cbake6807/PICO-SIGGEN-v1/GatedPulsePico/GatedPulsePico.ino

// GatedPulsePico — networked gated pulse-train generator, Raspberry Pi Pico 2 W
//
// Port of ../GatedPulse (Arduino Nano). Same knob/serial UX, but the RP2350
// changes the design: PIO does the gating in hardware, so the AVR's
// software-AND compromise is gone and no 74HC08 is needed.
//
//   ext sig gen ──► GP3 ─┐
//                        ├─► PIO gating SM ──► GP5   gated pulse train
//   int carrier ──► GP2 ─┘        ▲            GP4   gate / burst marker
//   (PIO gate_gen)                │
//                                 └─ COUNT: SM counts input pulses
//                                    TIME : second gate_gen SM drives GP4
//
// Edge fidelity, measured in clocks rather than guessed:
//   Nano software AND     562 ns worst-case error, 1.7 % blind time
//   Nano + 74HC08         ~10 ns, extra chip
//   Pico 2 W PIO          ~20 ns constant delay, +/-6.7 ns jitter, no extra parts
//
// PIO runs independently of the CPU, so WiFi, HTTP, USB and the encoder cannot
// perturb the output. On the Nano every one of those punched holes in it.
//
// Three ways to drive it, all sharing one command interpreter:
//   - rotary encoder + buttons
//   - USB serial (type ? for help)
//   - HTTP on the LAN:  GET /state          -> JSON
//                       GET /cmd?c=<command> -> runs any command, returns text
//                       GET /                -> small web UI
// tools/gatedpulse.py and tools/mcp_server.py on the host wrap the HTTP API.
//
// !! 3.3 V ONLY !! RP2350 GPIO is NOT 5 V tolerant, unlike the Nano this
// replaces. A 5 V sig-gen output WILL damage GP3. Use a divider (10k series +
// 20k to ground) or a 74LVC1G17 buffer on 3V3. See README.

#include <Arduino.h>
#include <stdio.h>            // sscanf, for parsing RAMP1/RAMP2's multi-value argument
#include <hardware/pio.h>
#include <hardware/pwm.h>
#include <hardware/clocks.h>
#include <hardware/gpio.h>
#include <hardware/dma.h>
#include <hardware/irq.h>
#include <string.h>           // memcpy/memset, for the settings blob
#include <EEPROM.h>           // emulated in one flash sector -- see cfgWrite()

// Forward-declared for arduino-cli's auto-generated prototypes. It inserts the
// whole block immediately above the file's FIRST function definition, so any
// struct a function signature mentions has to be declared above that point --
// and where that point lands moves whenever a helper is added near the top.
// Declaring every struct that appears in a signature here makes the build
// independent of that, rather than quietly breaking on the next edit. A
// reference to an incomplete type is perfectly legal in a declaration.
struct Settings;
struct RampCfg;
struct ElongCfg;
struct SeqStep;
#include <WiFi.h>
#include <WebServer.h>
#include <HTTPUpdateServer.h>
#include <LittleFS.h>
#include <LEAmDNS.h>

// WiFi credentials live in secrets.h, which is gitignored. Without it the
// firmware still builds and runs — it just stays offline.
#if __has_include("secrets.h")
  #include "secrets.h"
#endif
#ifndef WIFI_SSID
  #define WIFI_SSID ""
  #define WIFI_PASS ""
#endif
#ifndef MDNS_NAME
  #define MDNS_NAME "gatedpulse"
#endif

// Which firmware is this? Reported in /state, P and the boot banner, so "is
// the board running the new page or the old one" is answered by the board
// rather than guessed from what the UI looks like. FW_BUILD comes from
// build_info.h, which `make pico` writes from git; a bare arduino-cli build
// falls back to the compile time.
#define FW_VERSION "2.0.0"
#if __has_include("build_info.h")
  #include "build_info.h"
#endif
#ifndef FW_BUILD
  #define FW_BUILD __DATE__ " " __TIME__
#endif

// Firmware update over WiFi (POST /update), the way to reflash a board that
// is wired into a bench rig instead of sitting on the desk by a USB port.
// Off unless secrets.h sets OTA_PASS -- an unauthenticated flash endpoint on
// a box that drives high-voltage hardware is not a default worth shipping.
#ifndef OTA_USER
  #define OTA_USER "gatedpulse"
#endif
#ifndef OTA_PASS
  #define OTA_PASS ""
#endif

// ---------- Pins ----------
// GP3 is odd on purpose: PWM channel B is the one with an edge-count input
// mode, and channel B lives on odd GPIOs. GP4/GP5 are adjacent on purpose so
// one SET pin group can drive both in COUNT mode.
static const uint PIN_CARRIER    = 2;   // internally generated carrier (SRC INT)
static const uint PIN_SIG_IN     = 3;   // external sig-gen square wave (3.3 V!)
static const uint PIN_GATE_OUT   = 4;   // gate / burst marker — scope trigger
static const uint PIN_GATED_OUT  = 5;   // the gated pulse train
static const uint PIN_ENC_A      = 6;
static const uint PIN_ENC_B      = 7;
static const uint PIN_ENC_SW     = 8;   // press: select which param the knob edits
static const uint PIN_DISABLE    = 9;   // press: output on/off
static const uint PIN_MODE_SW    = 10;  // toggle: LOW = TIME, HIGH = COUNT
static const uint PIN_STATUS_LED = 15;  // external LED + resistor

// HV enclosure interlock. Board pin 31, with AGND right beside it at pin 33,
// so the whole connection is a two-pin header.
//
// Polarity is chosen so every way this can break lands on "unsafe":
//   closed (safe)  = pin pulled to GND by the sensor or switch
//   open           = pin floats to the internal pull-up
// A cut wire, an unpowered sensor, or nothing plugged in at all reads HIGH,
// which is the open case. The alternative polarity would report "lid closed"
// for a disconnected cable, which is exactly the failure a safety input exists
// to catch. Same pull-up-and-switch-to-ground convention as every other input
// here (RP2350 erratum E9 rules out the pull-downs).
static const uint PIN_INTERLOCK  = 26;  // board pin 31, GND at pin 33

// Second and third encoders: independent carrier controls. GP15 is skipped
// (status LED) and GP23/24/25/29 are avoided even though this board doesn't
// break them out at all -- on the plain Pico W they are wired straight to the
// CYW43 radio, so staying off that range is a cheap habit to keep.
static const uint PIN_ENC2_A     = 11;  // carrier frequency, or T1 width in T12 mode
static const uint PIN_ENC2_B     = 12;
static const uint PIN_ENC2_SW    = 13;  // press: toggle freq+duty vs T1/T2-independent editing
static const uint PIN_ENC3_A     = 14;  // carrier duty, or T2 space in T12 mode
static const uint PIN_ENC3_B     = 16;
static const uint PIN_ENC3_SW    = 17;  // press: toggle T1/T2 elongation ramp on/off

// Amplitude / tap select: 3 consecutive pins driven by the elongation SM's OUT
// group, intended for a 74HC138-style one-hot decoder feeding one opto +
// high-side leg per level. A decoder rather than three independent enables on
// purpose: two taps of one winding conducting at once shorts the turns between
// them, and one-hot in hardware makes that combination unreachable no matter
// what the firmware asks for. Harmless when nothing is wired -- the pins just
// toggle into open air.
// Dedicated panel button for the output mode (single / offset / sync). It gets
// its own pin because the modes are INDEPENDENT axes -- you may well want
// elongation with offset, or sweep with sync -- and folding them into one
// cycling control made combinations unreachable.
static const uint     PIN_PHASE_SW = 21;   // board pin 27, GND at pin 28

// ---- front-panel input map + event log ------------------------------------
// Wiring an encoder panel is the one job where "it does nothing" has half a
// dozen indistinguishable causes: A and B swapped, the common not grounded, a
// joint that never took, the wrong board pin counted from the wrong end. The
// raw edge log separates them in seconds -- if a pin never toggles it is the
// wiring, and if it toggles but no step is ever decoded it is the pairing.
//
// Board pin numbers live here too, because that is the number you count on the
// header while probing, and having to cross-reference GP-to-board in the
// middle of debugging is how the wrong pin gets blamed.
struct InputPin { uint gp; uint8_t board; const char *name; };
static const InputPin INPUTS[] = {
  { PIN_ENC_A,     9, "enc1 A"  }, { PIN_ENC_B,   10, "enc1 B"  },
  { PIN_ENC_SW,   11, "enc1 sw" }, { PIN_DISABLE, 12, "out en"  },
  { PIN_MODE_SW,  14, "T/C sw"  }, { PIN_ENC2_A,  15, "enc2 A"  },
  { PIN_ENC2_B,   16, "enc2 B"  }, { PIN_ENC2_SW, 17, "enc2 sw" },
  { PIN_ENC3_A,   19, "enc3 A"  }, { PIN_ENC3_B,  21, "enc3 B"  },
  { PIN_ENC3_SW,  22, "enc3 sw" }, { PIN_PHASE_SW, 27, "mode sw" },
};

// Kinds: 0 = raw pin edge, 1 = decoded detent step.
// kind 2 carries `msg` -- what the firmware DECIDED the input meant. Raw
// edges tell you the wiring is sound; this tells you the knob you turned moved
// the parameter you expected, which is a different failure and a commoner one.
struct InEvent { uint32_t ms; uint8_t gp; uint8_t level; uint8_t kind;
                 int8_t step; char msg[28]; };
static const uint16_t INLOG_MAX = 128;
static InEvent  inLog[INLOG_MAX];
static uint32_t inLogSeq = 0;          // total ever logged; the UI polls "since"

static void inLogPush(uint8_t gp, uint8_t level, uint8_t kind, int8_t step) {
  InEvent &e = inLog[inLogSeq % INLOG_MAX];
  e.ms = millis(); e.gp = gp; e.level = level; e.kind = kind; e.step = step;
  e.msg[0] = 0;
  inLogSeq++;
}

// What the panel just did, in words. Called from the apply/toggle paths where
// the firmware already knows the outcome, so the log cannot drift from what
// actually happened.
static void inLogAction(const char *fmt, ...) {
  InEvent &e = inLog[inLogSeq % INLOG_MAX];
  e.ms = millis(); e.gp = 0; e.level = 0; e.kind = 2; e.step = 0;
  va_list ap; va_start(ap, fmt);
  vsnprintf(e.msg, sizeof(e.msg), fmt, ap);
  va_end(ap);
  inLogSeq++;
}

// Every input, every loop. Deliberately NOT debounced and NOT filtered: bounce
// is one of the things you are looking for, and a "clean" log would hide the
// noisy contact that is actually causing the miscounts.
static void pollInputWatch() {
  static uint32_t last = 0;
  static bool     primed = false;
  uint32_t m = 0;
  for (uint i = 0; i < count_of(INPUTS); i++)
    if (gpio_get(INPUTS[i].gp)) m |= (1u << i);
  if (!primed) { last = m; primed = true; return; }
  uint32_t diff = m ^ last;
  if (!diff) return;
  for (uint i = 0; i < count_of(INPUTS); i++)
    if (diff & (1u << i)) inLogPush((uint8_t)INPUTS[i].gp, (m >> i) & 1u, 0, 0);
  last = m;
}

// Runtime-settable (PHASEPIN), not a constant: every panel is wired
// differently, and the base only has to satisfy "three consecutive free GPIOs".
// Baking it in meant anyone whose encoders landed here had to edit and rebuild.
static uint           ampBase    = 18;  // default GP18/19/20 = A0/A1/A2
static const uint     AMP_BITS   = 3;
static const uint32_t AMP_MASK   = (1u << AMP_BITS) - 1;   // codes 0..7

// Cycle marker: high for the whole of burst 1 of the repeating pattern, low for
// every other burst. It exists because GP4 pulses on EVERY burst, so in offset
// mode a scope has no way to tell burst 1 from burst 3 and the trace walks --
// the workaround was triggering off one channel with holdoff, which is fragile
// and drifts the moment the ring length changes.
//
// It rides the same OUT group as the channel bits rather than a second state
// machine, so it is generated from the same DMA word that picks the channel and
// cannot drift from it by even a clock. PIO pin groups are consecutive, so
// reaching GP22 from base GP18 means a 5-wide group, and bit 3 lands on GP21 --
// the mode button. That bit is simply never driven: GP21's function stays SIO,
// so the PIO block is not connected to that pad and its writes there go
// nowhere. Costs one wasted bit in the pushed word and nothing at runtime.
static const uint     CYCLE_BIT  = 4;                       // bit 3 = GP21 hole
static const uint     OUT_BITS   = CYCLE_BIT + 1;           // GP18..GP22
static const uint32_t CYCLE_MASK = 1u << CYCLE_BIT;
static inline uint    cyclePin()  { return ampBase + CYCLE_BIT; }   // GP22

// Named PIN_STATUS_LED, not PIN_LED: the rpipico2w variant already defines
// PIN_LED as 64, because the onboard LED hangs off the CYW43 WiFi chip rather
// than a GPIO. That one is used for link status once WiFi is up.

// ============================================================================
// PIO programs
// ============================================================================
//
// Hand-maintained encodings — arduino-cli does not run pioasm during a sketch
// build. The .pio sources next to this file are the readable original, and
// `make pioverify` re-assembles them and diffs against these arrays, so the
// two cannot silently drift.

// ---- Combined gating program (gating.pio) --------------------------------
//
// Both engines live in ONE program so dynamic PIO claiming can never split
// them across blocks. COUNT entry = offset+0, TIME entry = offset+17.
//
// The SET pin group differs per mode and is configured on the state machine:
//   COUNT: base GP4, count 2  -> bit0 = burst marker, bit1 = gated output
//   TIME : base GP5, count 1  -> bit0 = gated output
//
// COUNT half: passes ON input pulses then mutes OFF input pulses, forever, with
// no CPU involvement. It only ever raises the output after a rising edge and
// lowers it after the matching falling edge, so every burst is exactly ON
// *whole* pulses — no runts, at any input frequency.
//
// TIME half: ANDs the input with a gate level read through JMP_PIN. The `wait 0`
// before each pulse is what keeps it runt-free — a gate opening mid-pulse skips
// the remainder and starts clean on the next rising edge. Gate closure is
// likewise deferred to the end of the pulse in flight, at most one input period.
static const uint16_t gating_insns[] = {
  0x2020,  //  0: wait 0 pin 0        sync: begin from a low input  <-- COUNT entry
  0x8080,  //  1: pull noblock      burst: OSR = new word, or X (current)
  0xa027,  //  2: mov  x, osr       got:   keep it for the next burst
  0x6050,  //  3: out  y, 16          Y = ON-1
  0xe001,  //  4: set  pins, 1        marker high, output low
  0x20a0,  //  5: wait 1 pin 0      pass:
  0xe003,  //  6: set  pins, 3        output follows input
  0x2020,  //  7: wait 0 pin 0
  0xe001,  //  8: set  pins, 1
  0x0085,  //  9: jmp  y--, 5
  0xe000,  // 10: set  pins, 0        burst over, marker low
  0x6050,  // 11: out  y, 16          Y = OFF
  0x0072,  // 12: jmp  !y, 18         0 = one-shot -> park
  0x008e,  // 13: jmp  y--, 14        pre-decrement: mute counts OFF pulses
  0x20a0,  // 14: wait 1 pin 0      mute:
  0x2020,  // 15: wait 0 pin 0
  0x008e,  // 16: jmp  y--, 14
  0x0001,  // 17: jmp  1
  0x80a0,  // 18: pull block        park: one-shot done, wait for a word
  0x0002,  // 19: jmp  2
  0x00d7,  // 20: jmp  pin, 23     tloop:   <-- TIME entry
  0xe000,  // 21: set  pins, 0        gate shut, hold low
  0x0014,  // 22: jmp  20
  0x2020,  // 23: wait 0 pin 0     topen:
  0x20a0,  // 24: wait 1 pin 0
  0xe001,  // 25: set  pins, 1
  0x2020,  // 26: wait 0 pin 0
  0xe000,  // 27: set  pins, 0
  0x0014,  // 28: jmp  20
};
static const pio_program_t gating_program = {
  .instructions = gating_insns,
  .length       = count_of(gating_insns),
  .origin       = -1,
};
static const uint GATING_ENTRY_COUNT = 0;
static const uint GATING_ENTRY_TIME  = 20;

// ---- Square-wave generator (gate_gen.pio) --------------------------------
//
// Independent 32-bit high and low counts. Replaces the AVR's Timer1: that
// topped out at a 4.19 s period, this reaches hours while still resolving
// 6.67 ns at clkdiv 1. Two instances run: the TIME-mode gate, and the internal
// carrier. Fixed loop overhead is compensated on the CPU side —
// high = N + 3 cycles, low = M + 4 cycles (see genCycles()).
static const uint16_t gate_gen_insns[] = {
  0x80a0,  //  0: pull block          OSR = low-1
  0xa0c7,  //  1: mov  isr, osr
  0x80a0,  //  2: pull block          OSR = high-1
  0xa027,  //  3: mov  x, osr       cycle:
  0xe01f,  //  4: set  pins, 31     all bits of the SET group -- see the .pio
  0x0045,  //  5: jmp  x--, 5      hi:
  0xa046,  //  6: mov  y, isr
  0xe000,  //  7: set  pins, 0
  0x0088,  //  8: jmp  y--, 8      lo:
  0x0003,  //  9: jmp  3
};
static const pio_program_t gate_gen_program = {
  .instructions = gate_gen_insns,
  .length       = count_of(gate_gen_insns),
  .origin       = -1,
};

// ---- Retunable square wave (carrier_live.pio) -----------------------------
//
// gate_gen loads its two counts once, so retuning it meant stopping it and
// starting a new one: the current pulse was cut short and the burst count
// downstream restarted. Every edit -- every detent of a drag -- was a glitch.
//
// This one re-reads ONE packed word (low half hi-3, high half lo-5) at the top
// of every period with a nonblocking pull. An empty FIFO makes that pull act
// as `mov osr, x`, and X holds the current word, so the wave repeats until the
// CPU posts a new one; then T1 and T2 change together at a period boundary.
// Used for the internal carrier and for the TIME-mode gate. The frequency
// sweep keeps gate_gen, which it retunes through the clock divider instead.
//   hi_cycles = pushed + 3    set pins,31 .. set pins,0
//   lo_cycles = pushed + 5    set pins,0 .. next set pins,31 (wrap + reload)
static const uint16_t carrier_live_insns[] = {
  0x8080,  //  0: pull noblock        OSR = new word, or X (current)  wrap_target
  0xa027,  //  1: mov  x, osr
  0x6050,  //  2: out  y, 16          Y = hi-3
  0xe01f,  //  3: set  pins, 31
  0x0084,  //  4: jmp  y--, 4       hi:
  0x6050,  //  5: out  y, 16          Y = lo-5
  0xe000,  //  6: set  pins, 0
  0x0087,  //  7: jmp  y--, 7       lo:                               wrap
};
static const pio_program_t carrier_live_program = {
  .instructions = carrier_live_insns,
  .length       = count_of(carrier_live_insns),
  .origin       = -1,
};

// ---- Elongation burst generator (elongate.pio) ----------------------------
//
// Unlike gate_gen (a free-running carrier, gated by a SEPARATE counting SM
// that has no idea what the carrier is doing), this ONE state machine owns a
// whole COUNT-mode burst itself: on-phase pulses fed one at a time from a
// small DMA-streamed table, off-phase a plain countdown. "Pulse 1 of this
// burst" is naturally wherever its own program counter loops back to, so no
// cross-SM sync is needed to keep the shape locked to burst boundaries.
//
// SET pin group: base GP4, count 2 -> bit0 = marker (GP4), bit1 = output (GP5),
// same layout as the normal COUNT-mode gating program.
//
// OUT pin group: base GP18, count 5 -> bits 0..2 = channel / tap select
// (GP18-20), bit 3 unused (GP21, left on SIO for the mode button), bit 4 = the
// cycle marker (GP22).
//
// The channel has to drop between pulses (each channel carries the real pulse
// train, not a burst-wide envelope) while the cycle marker has to stay up
// across the whole burst. Both live in the same OUT group, so one write cannot
// do both -- and a NARROWER write does not help, which is the trap here:
//
//   `out pins, 3` on a 5-wide group does NOT leave GP21/GP22 untouched.
//
// The pin-write mask comes from the group's configured OUT_COUNT, not from the
// instruction's bit count, so a short OUT zero-fills the rest of the group.
// This was measured on the bench (GP22 read 1.0% duty where a latched marker
// would read 33%) after an earlier version of this program relied on the
// opposite, and it is worth knowing because it contradicts the natural reading
// of the instruction set.
//
// So the between-pulses value is carried in a register instead. Each burst
// parks a "gap mask" in ISR -- the cycle bit alone, or 0 -- and the low phase
// does `mov osr, isr` + a FULL-WIDTH out. Same instruction count as the
// `mov osr, null` it replaces, so no timing derivation below moves.
//
// Every burst the TX FIFO is fed (DMA, one linear transfer re-armed on
// completion by the DMA's own IRQ -- see elongDmaIrqHandler()), in EXACTLY
// the order the program below pulls it:
//   N-1, the gap mask, then N triples of
//   (select code, hi_cycles-1, lo_cycles-1), then
//   mute_cycles-1 LAST (pulled once, after the on-phase loop below exits --
//   not second, or pulse 1 gets fed the mute count instead of its own
//   hi-phase).
// The select lane is pulled at the START of each low phase rather than just
// before the next rising edge, so it has the whole of T2 to settle -- an opto
// downstream of the decoder needs microseconds, not the ~27 ns four clocks
// would buy.
// Loop overhead, worked out instruction-by-instruction against the listing
// below (each is "until the pins next actually move", so loop-exit and the
// following setup instructions count):
//   hi_cycles   = pushed+4    set pins,3 .. set pins,1
//   lo_cycles   = pushed+9    set pins,1 .. the next set pins,3, including the
//                             closing `jmp x--` and the next pulse's setup
//   mute_cycles = pushed+11   set pins,0 .. the next burst's set pins,3, past
//                             instr21's jmp and the whole burst_start preamble
// Only the mute constant moved when the gap mask was added (9 -> 11): its two
// new instructions sit in the burst_start preamble, inside the window the mute
// is measured over. hi and lo are UNCHANGED -- nothing was inserted between
// `set pins,3` and `set pins,1`, and the low phase swapped one MOV for another
// -- so an exactly 1.000 us T1 still lands on 150 integer clocks.
static const uint16_t elongate_insns[] = {
  0x80a0,  //  0: pull block          OSR = N-1                   burst_start:
  0xa027,  //  1: mov  x, osr
  0x80a0,  //  2: pull block          OSR = gap mask (cycle bit alone, or 0)
  0xa0c7,  //  3: mov  isr, osr         parked for every gap in this burst
  0x80a0,  //  4: pull block          OSR = channel mask | cycle   pulse:
  0x6005,  //  5: out  pins, 5          channel HIGH (before the pulse)
  0x80a0,  //  6: pull block          OSR = hi-1
  0xa047,  //  7: mov  y, osr
  0xe003,  //  8: set  pins, 3
  0x0089,  //  9: jmp  y--, 9       hi:
  0x80a0,  // 10: pull block          OSR = lo-1
  0xa047,  // 11: mov  y, osr
  0xe001,  // 12: set  pins, 1
  0xa0e6,  // 13: mov  osr, isr        the gap mask, not zero -- holds GP22
  0x6005,  // 14: out  pins, 5         channel LOW, marker unchanged
  0x008f,  // 15: jmp  y--, 15      lo:
  0x0044,  // 16: jmp  x--, 4         more pulses this burst?
  0x80a0,  // 17: pull block          OSR = mute-1
  0xa047,  // 18: mov  y, osr
  0xe000,  // 19: set  pins, 0
  0x0094,  // 20: jmp  y--, 20      mute:
  0x0000,  // 21: jmp  0
};
static const pio_program_t elongate_program = {
  .instructions = elongate_insns,
  .length       = count_of(elongate_insns),
  .origin       = -1,
};

// PIO resources are claimed cooperatively rather than hardcoded: on a Pico W
// the CYW43 WiFi chip is itself driven by a PIO state machine, allocated with
// pio_claim_free_sm_and_add_program_for_gpio_range(). Hardcoding pio0/pio1
// would risk silently fighting it. RP2350 has three PIO blocks, so asking the
// SDK for free ones always succeeds here regardless of init order.
static PIO  pioGate = nullptr;  static uint smGate = 0;  static uint offGating = 0;
static PIO  pioGen  = nullptr;  static uint smGen  = 0;  static uint offGen    = 0;
static uint smCarrier = 0;
// The retunable generators: internal carrier and TIME-mode gate. Their own
// block, because the program differs from gate_gen's. smCarrier above is
// still the sweep's GP2 generator.
static PIO  pioLive = nullptr;  static uint smCarLive = 0, smGateLive = 0, offLive = 0;
static bool liveReady = false;
static bool liveOn    = true;    // LIVE 0 forces the old restart-on-every-edit
                                 // path, for A/B on a scope
// Third generator, claimed only for the frequency sweep. pioGen has four state
// machines and the normal paths use two, so this costs nothing anyone else
// wanted. -1 = none available; the sweep then runs on GP5/GP2 alone rather
// than refusing to start.
static int  smSweepCh = -1;
static bool pioReady  = false;

static PIO  pioElong = nullptr; static uint smElong = 0; static uint offElong = 0;
static bool elongPioReady = false;
// Declared up here because applyGate() clears it when it routes to the normal
// carrier+gate path, and that sits well above the ring itself.
static volatile uint32_t ringLen = 0;       // 0 = no ring, single table
static int  elongDmaChan  = -1;

// ============================================================================
// Parameters
// ============================================================================

enum GateMode : uint8_t { MODE_TIME = 0, MODE_COUNT = 1 };
static GateMode gateMode = MODE_COUNT;

// Where the pulses being gated come from. INT runs a second copy of gate_gen
// as a carrier oscillator on GP2 and gates that, so the box is a complete burst
// generator with nothing attached. The gating engine cannot tell the difference
// — it just reads a different input pin.
enum SigSource : uint8_t { SRC_EXT = 0, SRC_INT = 1 };
static SigSource sigSource = SRC_EXT;

// What the two carrier encoders (GP11/12 and GP14/16) currently edit. Same
// two representations the dashboard's fd/t12 toggle already offers -- this
// just brings that choice to the front panel, via the ENC2 pushbutton.
enum ShapeMode : uint8_t { SHAPE_FD = 0, SHAPE_T12 = 1 };
static ShapeMode shapeMode = SHAPE_FD;

// COUNT mode. PIO counters are 32-bit, so the Nano's 65536-total ceiling is
// gone; 1e9 is a UI sanity limit, not a hardware one.
static uint32_t onCount  = 10;
static uint32_t offCount = 90;
static const uint32_t COUNT_MIN = 1;
// 65535: ON and OFF travel to the gating engine as two 16-bit halves of one
// word, so they change together at a burst boundary without a restart (see
// gating.pio). At 100 kHz that is still a 0.65 s gap.
static const uint32_t COUNT_MAX = 65535UL;

// TIME mode. Nanoseconds needs 64 bits now that the range reaches 60 s.
static uint64_t gatePeriodNs = 10000000ULL;   // 10 ms -> 100 Hz
static uint32_t gateDutyPpm  = 100000UL;      // 10 %
static const uint64_t PERIOD_NS_MIN = 1000ULL;           // 1 us
static const uint64_t PERIOD_NS_MAX = 60000000000ULL;    // 60 s
static const uint32_t DUTY_PPM_MIN  = 100UL;             // 0.01 %
static const uint32_t DUTY_PPM_MAX  = 999900UL;          // 99.99 %

static uint64_t carrierPeriodNs = 10000ULL;   // 10 us -> 100 kHz
static uint32_t carrierDutyPpm  = 500000UL;   // 50 %
static const uint64_t CARRIER_NS_MIN = 200ULL;           // 5 MHz
static const uint64_t CARRIER_NS_MAX = 1000000000ULL;    // 1 Hz

// T1/T2 elongation ramp. Auto-steps the carrier's own width (T1) and/or space
// (T2) by a fixed amount every N bursts, holding or wrapping back to the start
// once a limit is reached -- e.g. to sweep toward a resonance/breakdown point
// repeatably instead of hand-tuning into it every time. Independent of COUNT
// vs TIME gate mode: this only ever touches carrierPeriodNs/carrierDutyPpm,
// the same state C/CD already own, so it needs no PIO changes at all -- it
// rides the same live-reconfigure path a manual carrier edit already uses.
struct RampCfg {
  bool     active        = false;
  bool     wrap          = false;   // false = hold at the limit, true = restart at startNs
  int64_t  stepNs        = 0;       // signed: +grow, -shrink
  uint32_t burstsPerStep = 1;
  uint64_t limitNs       = 0;       // stepping stops/wraps once reached (direction = sign of stepNs)
  uint64_t startNs       = 0;       // T1/T2 value when armed -- the wrap target
  uint64_t nextStepAtUs  = 0;       // absolute time_us_64() deadline for the next step
};
// What the mode knob arms when it lands on SWEEP. Seeded with a usable default
// so the button does something sensible on a fresh board, then overwritten by
// whatever RAMP1 was last given -- the knob should re-arm the sweep you set up,
// not a canned one.
static int64_t  sweepStepNs  = 200;      // 0.2 us per step
static uint32_t sweepBursts  = 50;
static uint64_t sweepLimitNs = 9000;     // 9 us
static bool     sweepWrap    = true;

// ---- Continuous frequency sweep -------------------------------------------
//
// A different animal from RAMP1/RAMP2 above. Those step the carrier BETWEEN
// bursts. This throws the gating away entirely and walks a continuous 50%
// square from ~0 up to a ceiling and back, forever -- the "find the resonance"
// mode: no bursts to correlate, just one tone moving through the band while
// you watch a current probe.
//
// Frequency comes from the PIO CLOCK DIVIDER, not from new counts. gate_gen
// pulls its hi/lo once and then loops on registers, so changing the counts
// means re-initing the state machine -- which resets its program counter and
// emits a runt pulse on every single step of the sweep. Writing CLKDIV on a
// LIVE state machine instead changes the rate with no restart and no runt: the
// half-cycle in flight simply finishes at the new rate. It also holds the duty
// at EXACTLY 50% across the whole sweep, because hi and lo stay equal integers
// and only the clock feeding them moves.
static bool     fsweepOn       = false;
static uint32_t fsweepPeriodMs = 2000;    // one full 0 -> hi -> 0 -> cycle
static uint32_t fsweepHiHz     = 10000;   // ceiling of the sweep
static uint32_t fsweepHalf     = 0;       // PIO cycles per half period at div 1
static uint64_t fsweepT0Us     = 0;
static double   fsweepNowHz    = 0.0;     // published for the readout
static bool     fsweepRising   = true;

static const uint32_t FSWEEP_MS_MIN = 50;
static const uint32_t FSWEEP_MS_MAX = 120000;
static const uint32_t FSWEEP_HI_MIN = 10;
static const uint32_t FSWEEP_HI_MAX = 2000000;

static RampCfg ramp1;   // T1 = carrier ON width
static RampCfg ramp2;   // T2 = carrier OFF width (space)

// Elongation: each pulse in a COUNT-mode burst compounds off the last, T1 and
// T2 independently -- pulse 1 is exactly the base T1/T2 the ENC2/ENC3 knobs
// set. Distinct from RAMP1/RAMP2 above: those step the carrier BETWEEN bursts
// over many seconds; this reshapes pulses WITHIN a single burst, which needs
// the dedicated elongate_program SM rather than the normal carrier+gate pair
// -- see elongArm()/elongStart() near applyGate().
//
// The stored knob is `ratio`: the TOTAL span across the burst (last pulse /
// first pulse), NOT the per-pulse multiplier. The per-pulse factor is derived
// from it and the pulse count. That distinction is the whole point, because
// the compounding is exponential in onCount: a fixed per-pulse 1.618 is a
// pleasant 76x span over 10 pulses and an unusable 103,682x over 25, which
// saturates elongNsToCycles() and flattens the tail into a row of identically
// clamped pulses. Holding the TOTAL span fixed instead makes the burst's
// shape independent of how many pulses are in it -- dial "10x across the
// burst" and it reads the same at N=5 and at N=25, which is what you actually
// want when sweeping pulse count against a load.
struct ElongCfg {
  bool   active = false;
  double ratio  = 8.0;    // default if armed before ever being configured
};
static ElongCfg elong;
// Was 25, and the binding constraint was never the PIO or the DMA -- it was
// that this same constant sizes the persisted seqSteps[] array, which had to
// fit the 512-byte settings budget. Raising the budget (still one flash
// sector) lifts both together, so a 100-pulse burst and a 100-step SEQ table
// stay the same number rather than becoming two limits to remember.
//
// Costs, both checked: the burst ring grows to RING_MAX * (3 + 3*N) words
// (24 * 303 * 4 = 29 KB of RAM, against ~436 KB free), and Settings grows to
// ~1.3 KB, guarded by the static_assert next to CFG_EE_SIZE.
static const uint32_t ELONG_MAX_PULSES = 100;
static const double   ELONG_RATIO_MIN  = 0.01;
static const double   ELONG_RATIO_MAX  = 1000.0;
static const double   ELONG_PHI        = 1.6180339887498949;

static bool outputEnabled = true;
static bool gateInvert    = false;   // swap the open/closed phases
static bool pulseInvert   = false;   // hardware pad inverter on the output

// ---- HV interlock ---------------------------------------------------------
// Two separate things, deliberately not merged:
//   outputEnabled     what the operator asked for
//   interlockTripped  what the enclosure says it is allowed to do
// Folding the interlock into outputEnabled would let a trip get written to
// flash as an intent, so re-arming would silently restore a state the operator
// never chose -- and worse, the saved "output off" would look like a setting
// rather than a fault.
//
// Latching on purpose. An interlock that clears itself the moment the lid
// shuts brings HV back up with nobody's hand on a control; the operator has to
// say ARM. That is the whole difference between an interlock and a switch.
static bool     interlockEnabled  = false;   // persisted; off unless wired
static bool     interlockTripped  = false;   // runtime only, never saved
static uint32_t interlockOpenAt   = 0;       // first HIGH sample of a trip
static uint32_t interlockShutAt   = 0;       // start of the current closed run
static uint32_t interlockTrips    = 0;       // since boot, for the readout

// Asymmetric on purpose: 2 ms to trip rejects a dV/dt spike coupled off the
// coils without meaningfully delaying a real one (a lid cannot move in 2 ms),
// while 250 ms of *continuous* closure before ARM is accepted stops a bouncing
// or intermittent contact from being re-armed into.
static const uint32_t INTERLOCK_TRIP_MS = 2;
static const uint32_t INTERLOCK_SHUT_MS = 250;

static inline bool interlockClosed() { return gpio_get(PIN_INTERLOCK) == 0; }

// The one question the waveform path asks. Everything that used to test
// outputEnabled directly must test this instead, or the interlock is advice.
static inline bool outputLive() { return outputEnabled && !interlockTripped; }

// Live encoder debug -- off by default, toggled with ENCLOG. Declared up
// here (not down with the rest of the encoder code) because the ENCLOG
// command handler needs it and runCommand() comes before that section.
static bool encLogEnabled = false;

static uint8_t selParam = 0;         // 0 = ON/PERIOD, 1 = OFF/DUTY

// One-shot run window. `RUN <ms>` enables the output for exactly this long and
// then shuts it off again, which is what makes a scope capture correspond to a
// known experiment rather than to whenever you happened to press the button.
// Arm the scope single-shot on the GP4 burst marker first: the output is
// silent before RUN, so the scope cannot trigger on anything else.
static uint32_t runUntilMs = 0;      // 0 = not in a timed run
static uint32_t runLenMs   = 0;

// SHOT: emit exactly ONE burst, then stop. Rather than have the CPU chase the
// PIO to halt it mid-stream — which could truncate a pulse — this sets the mute
// count to its 32-bit maximum. The state machine emits its ON pulses, enters the
// mute loop, and parks there for 4.29e9 input pulses (over a day at 10 kHz), so
// the single burst is bounded by the PIO itself and is exactly as clean as a
// free-running one. Firing again is just another restart.
static bool shotMode = false;

static uint32_t achGenDiv = 1, achHiCyc = 0, achLoCyc = 0;
static uint32_t achCarDiv = 1, achCarHi = 0, achCarLo = 0;

static float measuredHz = 0.0f;      // EXT only; INT is computed exactly

// Frequency of whatever is actually feeding the gate.
static double sourceHz() {
  if (sigSource == SRC_INT) {
    if (!achCarHi && !achCarLo) return 0.0;
    double tick = (double)achCarDiv / (double)clock_get_hz(clk_sys);
    return 1.0 / (tick * (double)(achCarHi + achCarLo));
  }
  return (double)measuredHz;
}

// ============================================================================
// Gate engine
// ============================================================================

// Which engine is running and the setup it was started with. applyGate()
// compares against this to tell "a value moved" (retune in place, no glitch)
// from "the arrangement changed" (stop everything and start over).
enum Engine : uint8_t { ENG_NONE = 0, ENG_NORMAL, ENG_ELONG, ENG_SWEEP };
static uint8_t runEngine = ENG_NONE;
static uint8_t runSrc = 0, runMode = 0;
static bool    runShot = false;
static uint    runAmpBase = 0;

static void gateStop() {
  if (!pioReady) return;
  runEngine = ENG_NONE;
  if (liveReady) {
    pio_sm_set_enabled(pioLive, smCarLive,  false);
    pio_sm_set_enabled(pioLive, smGateLive, false);
  }
  pio_sm_set_enabled(pioGate, smGate,    false);
  pio_sm_set_enabled(pioGen,  smGen,     false);
  pio_sm_set_enabled(pioGen,  smCarrier, false);
  if (smSweepCh >= 0) pio_sm_set_enabled(pioGen, (uint)smSweepCh, false);
  if (elongPioReady) {
    pio_sm_set_enabled(pioElong, smElong, false);
    dma_channel_abort(elongDmaChan);
  }
}

// Hand every driven pin back to SIO and park it low. The amplitude select goes
// with them: leaving the last code latched would hold one decoder output — and
// therefore one high-side leg's opto — asserted after the output was stopped.
// Code 0 is the deselected state, so parking low deselects.
static void parkPins(const uint *pins, size_t n) {
  for (size_t i = 0; i < n; i++) {
    gpio_set_function(pins[i], GPIO_FUNC_SIO);
    gpio_set_dir(pins[i], GPIO_OUT);
    gpio_put(pins[i], 0);
  }
}

// Just the OUT group. Split out from gateParkPins() because the normal
// carrier+gate path needs it too: that path never drives these pins, so without
// it whatever the elongation engine last latched stays asserted after a mode
// change -- one decoder output (and therefore one high-side leg's opto) held
// on, and a cycle marker stuck high, with nothing running that would ever
// rewrite them.
static void ampParkPins() {
  const uint pins[] = { ampBase, ampBase + 1, ampBase + 2, cyclePin() };
  parkPins(pins, count_of(pins));
}

static void gateParkPins() {
  const uint pins[] = { PIN_GATED_OUT, PIN_GATE_OUT, PIN_CARRIER };
  parkPins(pins, count_of(pins));
  ampParkPins();
}

// Cycle counts for one gate_gen instance: pick a clock divider that keeps both
// half-periods inside a 32-bit counter, then split the period by duty. Shared
// by the TIME-mode gate and the internal carrier — same program, same maths.
static void genCycles(uint64_t periodNs, uint32_t dutyPpm, bool invert,
                      uint32_t *div, uint32_t *hi, uint32_t *lo) {
  uint64_t fsys  = clock_get_hz(clk_sys);
  uint64_t total = (periodNs * fsys) / 1000000000ULL;
  uint32_t d     = 1;
  while (total > 2000000000ULL) { d <<= 1; total >>= 1; }
  if (total < 7) total = 7;                       // 3 high + 4 low minimum

  uint64_t h = (total * dutyPpm) / 1000000ULL;
  if (invert) h = total - h;
  if (h < 3)         h = 3;
  if (h > total - 4) h = total - 4;

  *div = d;
  *hi  = (uint32_t)h;
  *lo  = (uint32_t)(total - h);
}

// Bring up one gate_gen state machine on `pin`. FIFO pushes must follow
// pio_sm_init(), which clears the FIFOs.
// `count` consecutive pins, all driven with the same waveform from one state
// machine. Everything except the frequency sweep passes 1.
static void startGenPins(uint sm, uint pin, uint count,
                         uint32_t div, uint32_t hi, uint32_t lo) {
  for (uint i = 0; i < count; i++) pio_gpio_init(pioGen, pin + i);
  pio_sm_set_consecutive_pindirs(pioGen, sm, pin, count, true);

  pio_sm_config g = pio_get_default_sm_config();
  sm_config_set_wrap(&g, offGen, offGen + gate_gen_program.length - 1);
  sm_config_set_set_pins(&g, pin, count);
  sm_config_set_clkdiv_int_frac(&g, div, 0);

  pio_sm_init(pioGen, sm, offGen, &g);
  pio_sm_put_blocking(pioGen, sm, lo - 4);   // consumed by pull #1
  pio_sm_put_blocking(pioGen, sm, hi - 3);   // consumed by pull #2
  pio_sm_set_enabled(pioGen, sm, true);
}

static void startGen(uint sm, uint pin, uint32_t div, uint32_t hi, uint32_t lo) {
  startGenPins(sm, pin, 1, div, hi, lo);
}

// Cycles for carrier_live: each half must fit 16 bits after its offset, so
// the integer clock divider takes up whatever the longer half needs beyond
// that. Below ~1 kHz that costs at most 1 part in 65535 of resolution.
// Returns real hi/lo cycle counts (not the pushed values), like genCycles().
static void liveCycles(uint64_t periodNs, uint32_t dutyPpm, bool invert,
                       uint32_t *div, uint32_t *hi, uint32_t *lo) {
  const uint64_t fsys  = clock_get_hz(clk_sys);
  uint64_t total = (periodNs * fsys) / 1000000000ULL;
  if (total < 8) total = 8;                        // 3 high + 5 low minimum
  uint32_t ppm = invert ? 1000000U - dutyPpm : dutyPpm;
  uint64_t big = (total * (ppm > 500000U ? ppm : 1000000U - ppm)) / 1000000ULL;
  uint64_t d   = (big + 65534ULL) / 65535ULL;     // ceil(big / 65535)
  if (d < 1) d = 1;
  if (d > 65535) d = 65535;
  uint64_t t = (total + d / 2) / d;
  if (t < 8) t = 8;
  uint64_t h = (t * ppm + 500000ULL) / 1000000ULL;
  if (h < 3)     h = 3;
  if (h > t - 5) h = t - 5;
  if (h > 65538)     h = 65538;
  if (t - h > 65540) t = h + 65540;
  *div = (uint32_t)d;
  *hi  = (uint32_t)h;
  *lo  = (uint32_t)(t - h);
}

static inline uint32_t liveWord(uint32_t hi, uint32_t lo) {
  return ((lo - 5) << 16) | ((hi - 3) & 0xFFFFu);
}

static void liveStart(uint sm, uint pin, uint32_t div, uint32_t hi, uint32_t lo) {
  pio_gpio_init(pioLive, pin);
  pio_sm_set_consecutive_pindirs(pioLive, sm, pin, 1, true);
  pio_sm_config g = pio_get_default_sm_config();
  sm_config_set_wrap(&g, offLive, offLive + carrier_live_program.length - 1);
  sm_config_set_set_pins(&g, pin, 1);
  sm_config_set_out_shift(&g, true, false, 32);   // right, NO autopull
  sm_config_set_clkdiv_int_frac(&g, div, 0);
  pio_sm_init(pioLive, sm, offLive, &g);
  pio_sm_put_blocking(pioLive, sm, liveWord(hi, lo));
  pio_sm_set_enabled(pioLive, sm, true);
}

// Hand a running state machine its next word. Only the NEWEST value matters:
// anything still queued from an earlier edit is dropped first, so a fast drag
// at a slow rate cannot build a backlog the output then plays through.
static void postWord(PIO pio, uint sm, uint32_t w) {
  if (!pio_sm_is_tx_fifo_empty(pio, sm)) pio_sm_clear_fifos(pio, sm);
  pio_sm_put(pio, sm, w);
}

// ON/OFF for the COUNT gating engine. OFF = 0 means one-shot.
static uint32_t gatingWord() {
  uint32_t on  = onCount  < COUNT_MIN ? COUNT_MIN : (onCount  > COUNT_MAX ? COUNT_MAX : onCount);
  uint32_t off = offCount < COUNT_MIN ? COUNT_MIN : (offCount > COUNT_MAX ? COUNT_MAX : offCount);
  if (gateInvert && !shotMode) { uint32_t t = on; on = off; off = t; }
  if (shotMode) off = 0;
  achHiCyc = on; achLoCyc = shotMode ? 0xFFFFFFFFUL : off; achGenDiv = 0;
  return (off << 16) | ((on - 1) & 0xFFFFu);
}

// Half-period in PIO cycles at divider 1. The two halves must be EQUAL
// integers or the duty is not exactly 50%, so the period is forced even and
// split down the middle; the achieved ceiling is reported back rather than the
// one that was asked for.
static uint32_t fsweepHalfCycles(uint32_t hiHz) {
  const uint64_t sys = clock_get_hz(clk_sys);
  uint64_t period = hiHz ? sys / hiHz : 15000ULL;
  if (period < 10) period = 10;         // keeps startGen's lo-4 at 1 or more
  uint32_t half = (uint32_t)(period / 2);
  return half < 5 ? 5 : half;
}

static double fsweepTopHz() {
  return fsweepHalf ? (double)clock_get_hz(clk_sys) / (2.0 * (double)fsweepHalf)
                    : 0.0;
}

// frac 0..1 across the sweep band. Divider only -- see the note at fsweepOn.
static void fsweepApply(double frac) {
  const double top = fsweepTopHz();
  const double hz  = frac * top;

  // div = top/hz, so hz -> 0 saturates the divider instead of dividing by
  // zero. The floor that lands on is top/65536 -- 0.15 Hz at a 10 kHz ceiling,
  // which is "zero" for bench purposes and is reported as the real number
  // rather than as 0.
  double divf = (hz > 0.0) ? (top / hz) : 65536.0;
  if (divf < 1.0)      divf = 1.0;
  if (divf > 65535.99) divf = 65535.99;

  uint32_t di = (uint32_t)divf;
  uint32_t df = (uint32_t)((divf - (double)di) * 256.0 + 0.5);
  if (df > 255)   { df = 0; di++; }
  if (di > 65535) { di = 65535; df = 255; }
  if (di == 0)    { di = 1; }           // 0 means 65536 in hardware -- never

  // Deliberately WITHOUT pio_sm_clkdiv_restart(): restarting the divider is
  // what re-aligns phase, and re-aligning phase a thousand times a second is
  // precisely the glitch this whole approach exists to avoid.
  pio_sm_set_clkdiv_int_frac(pioGen, smGen,     (uint16_t)di, (uint8_t)df);
  pio_sm_set_clkdiv_int_frac(pioGen, smCarrier, (uint16_t)di, (uint8_t)df);
  if (smSweepCh >= 0)
    pio_sm_set_clkdiv_int_frac(pioGen, (uint)smSweepCh, (uint16_t)di, (uint8_t)df);
  fsweepNowHz = top / ((double)di + (double)df / 256.0);
}

static void ampParkPins();

static void fsweepStart() {
  ringLen = 0;
  ampParkPins();
  fsweepHalf = fsweepHalfCycles(fsweepHiHz);

  // Equal hi and lo -- the 50% the mode promises, exact at every frequency.
  // GP5 is the output you drive things with; GP2 stays the carrier monitor it
  // is in every other mode, so a probe already there keeps working.
  startGen(smGen,     PIN_GATED_OUT, 1, fsweepHalf, fsweepHalf);
  startGen(smCarrier, PIN_CARRIER,   1, fsweepHalf, fsweepHalf);

  // All three channel pins carry the sweep, together -- the same arrangement
  // PHASE SYNC already makes, which is how this rig is driven. A sweep that
  // only appeared on GP5 would never reach the coils it exists to excite.
  //
  // One state machine drives all three, so they are not merely synchronised,
  // they are the same instruction: there is no skew between them to drift,
  // and no way for one to be left asserted if something goes wrong mid-change.
  //
  // Worth knowing rather than worth preventing: three legs conducting at once
  // is three times the draw on the shared rail. On a topology where these are
  // taps of ONE winding rather than separate cells, simultaneous conduction
  // shorts the turns between the taps -- that is what the one-hot decoder in
  // the normal channel path is for, and it is bypassed here.
  if (smSweepCh >= 0)
    startGenPins((uint)smSweepCh, ampBase, AMP_BITS, 1, fsweepHalf, fsweepHalf);

  // GP4 keeps its scope-trigger job but marks the SWEEP, not a burst: high
  // through the up-sweep, low through the down-sweep. One edge pair per cycle
  // to trigger on, and its level tells you which direction you are watching.
  gpio_set_function(PIN_GATE_OUT, GPIO_FUNC_SIO);
  gpio_set_dir(PIN_GATE_OUT, GPIO_OUT);
  gpio_put(PIN_GATE_OUT, 1);

  gpio_set_outover(PIN_GATED_OUT,
                   pulseInvert ? GPIO_OVERRIDE_INVERT : GPIO_OVERRIDE_NORMAL);
  applyChanMaskPads();          // after startGenPins' pio_gpio_init, not before
  fsweepT0Us   = time_us_64();
  fsweepRising = true;
  fsweepApply(0.0);          // start at the bottom, not at whatever div 1 is
}

// Defined down in the settings section; applyGate() is the one funnel every
// waveform change goes through, so it is where a save gets armed.
static void cfgTouch();

static bool applyLive();

static void applyGate() {
  if (!pioReady) return;
  cfgTouch();                 // arm a deferred save; the write happens once quiet
  // Only a value moved? Retune the running engine in place -- the output never
  // stops, the burst in flight finishes, and the change lands on the next
  // period or burst boundary. Everything else falls through to a restart.
  if (applyLive()) return;
  gateStop();

  // gateParkPins() takes the channel pins and the cycle marker down with it,
  // so a trip leaves nothing driven anywhere.
  if (!outputLive()) {
    gateParkPins();
    return;
  }

  // Checked before elongation, not alongside it: the sweep replaces the whole
  // carrier+gate arrangement rather than layering on it. There is no burst to
  // gate, no ring to rotate and no per-pulse table -- one continuous tone.
  if (fsweepOn) { fsweepStart(); runEngine = ENG_SWEEP; return; }

  // Elongation owns pulse generation itself (a burst's worth of T1/T2 pairs
  // it streams from its own table), so it fully replaces the normal
  // carrier+gate pair rather than layering on top of them -- meaningless
  // outside COUNT+INT, where "pulse 1..N of this burst" is well-defined.
  // PHASE lives on the elongation state machine -- it is the only one with an
  // OUT group and a per-burst DMA table. So the engine runs whenever EITHER is
  // wanted. With elongation off it simply emits a flat train, which is the
  // same waveform the normal carrier+gate path would have produced; before this
  // check included phaseMode, switching elongation off dropped back to that
  // path and the three channel pins went dead.
  if ((elong.active || phaseOn()) && elongPioReady
      && sigSource == SRC_INT && gateMode == MODE_COUNT) {
    elongStart();
    runEngine = ENG_ELONG; runAmpBase = ampBase;
    return;
  }
  // Falling through to the normal carrier+gate path: the ring belongs to the
  // elongation engine, so leave no stale length behind for the status readout
  // to report a pattern that is not running -- and no stale levels on the pins
  // only that engine drives.
  ringLen = 0;
  ampParkPins();
  applyChanMaskPads();

  // Internal carrier first, so the gating SM has something to read the instant
  // it starts. Its pin doubles as a plain sig-gen output you can tap.
  if (sigSource == SRC_INT) {
    uint32_t cdiv, chi, clo;
    if (liveReady) {
      liveCycles(carrierPeriodNs, carrierDutyPpm, false, &cdiv, &chi, &clo);
      liveStart(smCarLive, PIN_CARRIER, cdiv, chi, clo);
    } else {                                   // no spare SM: the old way
      genCycles(carrierPeriodNs, carrierDutyPpm, false, &cdiv, &chi, &clo);
      startGen(smCarrier, PIN_CARRIER, cdiv, chi, clo);
    }
    achCarDiv = cdiv; achCarHi = chi; achCarLo = clo;
  } else {
    achCarDiv = 0; achCarHi = 0; achCarLo = 0;
    gpio_set_function(PIN_CARRIER, GPIO_FUNC_SIO);
    gpio_set_dir(PIN_CARRIER, GPIO_OUT);
    gpio_put(PIN_CARRIER, 0);
  }
  const uint inPin = (sigSource == SRC_INT) ? PIN_CARRIER : PIN_SIG_IN;

  pio_sm_config c = pio_get_default_sm_config();
  sm_config_set_wrap(&c, offGating, offGating + gating_program.length - 1);
  sm_config_set_in_pins(&c, inPin);
  sm_config_set_clkdiv_int_frac(&c, 1, 0);   // full sys clock, lowest latency

  if (gateMode == MODE_COUNT) {

    // One SET group covers both pins: bit0 = GP4 marker, bit1 = GP5 output.
    pio_gpio_init(pioGate, PIN_GATE_OUT);
    pio_gpio_init(pioGate, PIN_GATED_OUT);
    pio_sm_set_consecutive_pindirs(pioGate, smGate, PIN_GATE_OUT, 2, true);
    sm_config_set_set_pins(&c, PIN_GATE_OUT, 2);
    sm_config_set_out_shift(&c, true, false, 32);    // right, NO autopull

    pio_sm_init(pioGate, smGate, offGating + GATING_ENTRY_COUNT, &c);
    pio_sm_put_blocking(pioGate, smGate, gatingWord());   // first burst's word
    pio_sm_set_enabled(pioGate, smGate, true);
  } else {
    uint32_t div, hi, lo;
    // Gate generator owns GP4 here, so the gating SM must not drive it: its
    // SET group is GP5 alone.
    if (liveReady) {
      liveCycles(gatePeriodNs, gateDutyPpm, gateInvert, &div, &hi, &lo);
      liveStart(smGateLive, PIN_GATE_OUT, div, hi, lo);
    } else {
      genCycles(gatePeriodNs, gateDutyPpm, gateInvert, &div, &hi, &lo);
      startGen(smGen, PIN_GATE_OUT, div, hi, lo);
    }
    achGenDiv = div; achHiCyc = hi; achLoCyc = lo;

    pio_gpio_init(pioGate, PIN_GATED_OUT);
    pio_sm_set_consecutive_pindirs(pioGate, smGate, PIN_GATED_OUT, 1, true);
    sm_config_set_set_pins(&c, PIN_GATED_OUT, 1);
    sm_config_set_jmp_pin(&c, PIN_GATE_OUT);

    pio_sm_init(pioGate, smGate, offGating + GATING_ENTRY_TIME, &c);
    pio_sm_set_enabled(pioGate, smGate, true);
  }

  // Must come last: gpio_set_function() (inside pio_gpio_init) zeroes every
  // CTRL field except FUNCSEL, so setting the pad inverter any earlier would be
  // silently wiped. The pad's own inverter costs zero PIO instructions.
  gpio_set_outover(PIN_GATED_OUT,
                   pulseInvert ? GPIO_OVERRIDE_INVERT : GPIO_OVERRIDE_NORMAL);
  runEngine = ENG_NORMAL;
  runSrc = sigSource; runMode = gateMode; runShot = shotMode;
}

// The no-restart path. Returns true if the change was applied to the running
// engine; false means the arrangement changed and applyGate() must restart.
// Everything is computed before anything is posted, so a false return never
// leaves an engine half-updated.
static bool applyLive() {
  if (!liveReady || !liveOn || !outputLive() || fsweepOn) return false;

  const bool wantElong = (elong.active || phaseOn()) && elongPioReady
                      && sigSource == SRC_INT && gateMode == MODE_COUNT;
  if (wantElong) {
    if (runEngine != ENG_ELONG || runAmpBase != ampBase) return false;
    elongRetune();
  } else {
    // A one-shot is a trigger: it restarts on purpose, so it is never live.
    if (runEngine != ENG_NORMAL || shotMode || runShot
        || runSrc != sigSource || runMode != gateMode) return false;
    uint32_t cdiv = 0, chi = 0, clo = 0, gdiv = 0, ghi = 0, glo = 0;
    if (sigSource == SRC_INT) {
      liveCycles(carrierPeriodNs, carrierDutyPpm, false, &cdiv, &chi, &clo);
      if (cdiv != achCarDiv) return false;     // divider change: restart
    }
    if (gateMode == MODE_TIME) {
      liveCycles(gatePeriodNs, gateDutyPpm, gateInvert, &gdiv, &ghi, &glo);
      if (gdiv != achGenDiv) return false;
    }
    if (sigSource == SRC_INT) {
      achCarHi = chi; achCarLo = clo;
      postWord(pioLive, smCarLive, liveWord(chi, clo));
    }
    if (gateMode == MODE_COUNT) {
      postWord(pioGate, smGate, gatingWord());
    } else {
      achHiCyc = ghi; achLoCyc = glo;
      postWord(pioLive, smGateLive, liveWord(ghi, glo));
    }
  }
  // Pad-level settings cost nothing to reapply and need no engine change.
  gpio_set_outover(PIN_GATED_OUT,
                   pulseInvert ? GPIO_OVERRIDE_INVERT : GPIO_OVERRIDE_NORMAL);
  applyChanMaskPads();
  return true;
}

// ---- Elongation: per-pulse compounding within one burst -------------------

// N-1, the gap mask, then N (select, hi-1, lo-1) triples, then mute-1 -- 3N+3
// words, which is what the expression below spells out. See elongate_insns
// above for the exact per-phase overhead the -1s compensate for.
static const uint32_t ELONG_WORDS = 3 + 3 * ELONG_MAX_PULSES;
// Two banks of everything the DMA reads. The live bank is never written: an
// edit builds the other one and the DMA IRQ switches over at the next burst
// boundary, so the engine never stops (see elongRetune()). elongTable and
// elongRing below always point at the live bank, so readers need not care.
static uint32_t elongTableBank[2][ELONG_WORDS];
static uint32_t *volatile elongTable = elongTableBank[0];
static volatile uint32_t elongTableLen = 0;

// ---- Per-train amplitude ring ---------------------------------------------
//
// A ring of complete burst tables, one per amplitude level, advanced by the
// DMA's own completion IRQ. Burst 1 fires table 0, burst 2 table 1, and so on,
// wrapping -- so an envelope can span a whole TRAIN of bursts instead of
// resetting every burst the way a single table does.
//
// Amplitude here is width: for an inductive primary i = V*T1/L, so scaling
// every T1 in a burst scales the energy that burst delivers. That needs no
// hardware at all -- unlike tap select, which needs the decoder and legs.
//
// The tables are built ONCE at arm time, never in the ISR. Building one calls
// pow() and does floating point, which has no business in an interrupt that
// fires every burst; the handler does nothing but move a pointer.
//
// Every table in the ring holds the same pulse count, so they are all the same
// length. That is what lets the ISR swap only the read address, exactly as the
// single-table path has always done -- no transfer-count reload, no change to
// a DMA pattern that already works.
static const uint32_t TRAIN_MAX = 8;
// The ring now carries TWO per-burst sequences -- amplitude level and output
// channel -- so its length is the lcm of the two, not just the level count.
// lcm(8,3) = 24 is the worst case, hence the separate cap.
static const uint32_t RING_MAX  = 24;
static uint32_t elongRingBank[2][RING_MAX][ELONG_WORDS];
static uint32_t (*volatile elongRing)[ELONG_WORDS] = elongRingBank[0];
// Bank handoff between elongRetune() (main loop) and the DMA IRQ.
static volatile uint8_t  eLive = 0, ePendBank = 0;
static volatile bool     ePend = false;
static volatile uint32_t ePendLen = 0, ePendRing = 0;
static uint8_t  trainAmp[TRAIN_MAX];        // percent of base T1, 1..100
static uint32_t trainLen = 0;               // 0 = ring off, single table
static volatile uint32_t trainIdx = 0;      // which table the NEXT burst uses

// ---- Output channel rotation (PHASE) --------------------------------------
//
// Fires one burst on GP18, the next on GP19, the next on GP20, then repeats --
// each separated by the normal off-time, because the mute is simply part of
// every burst's table. The three lines are the outputs themselves, driven by
// the same DMA stream as the timing, so no external logic is needed.
//
// PH_OFF hands the OUT lane back to SEQ's per-pulse codes for tap select. The
// two uses share three pins and are mutually exclusive.
//
//   PH_ROTATE  one burst per channel, advancing -- CH1, gap, CH2, gap, CH3...
//   PH_SYNC    all channels fire together on every burst
enum PhaseMode : uint8_t { PH_OFF = 0, PH_ROTATE = 1, PH_SYNC = 2 };
static uint8_t  phaseMode = PH_OFF;
// WHICH channels, not just how many. A count can only ever mean "the first n",
// which is no use once one channel's driver is dead: you need 2 and 3 without
// 1. phaseLen is kept as the derived popcount so every existing readout and
// the ring-length maths carry on working unchanged.
static uint8_t  phaseMask = (uint8_t)AMP_MASK;   // bit i = GP18+i
static uint32_t phaseLen  = 3;              // channels in use == popcount(mask)
static inline bool phaseOn() { return phaseMode != PH_OFF; }

static uint32_t phaseCount() {
  uint32_t n = 0;
  for (uint i = 0; i < AMP_BITS; i++) if (phaseMask & (1u << i)) n++;
  return n;
}

// Bit of the i-th ENABLED channel, so ROTATE walks only what is switched on.
// With channel 1 disabled it alternates GP19/GP20 instead of spending a third
// of every cycle driving a pin that goes nowhere.
static uint32_t nthChanBit(uint32_t i) {
  const uint32_t n = phaseCount();
  if (!n) return 0;
  i %= n;
  for (uint32_t b = 0; b < AMP_BITS; b++)
    if (phaseMask & (1u << b)) { if (!i) return 1u << b; i--; }
  return 0;
}

static void setPhaseMask(uint8_t m) {
  m &= (uint8_t)AMP_MASK;
  if (!m) m = (uint8_t)AMP_MASK;      // never leave zero channels selected
  phaseMask = m;
  phaseLen  = phaseCount();
}

// Force disabled channels low AT THE PAD, in every mode. The tables and the
// sweep already avoid them, so this is belt and braces -- but that is the
// right posture for a pin whose transistor has already let go once: no table
// bug, no half-applied mode change and no stale latched code can put a
// disabled channel back into conduction.
//
// Must run AFTER any pio_gpio_init() on these pads. gpio_set_function() zeroes
// every CTRL field except FUNCSEL, so an override set earlier is silently
// wiped -- the same trap the pulse inverter has to dodge.
static void applyChanMaskPads() {
  for (uint i = 0; i < AMP_BITS; i++)
    gpio_set_outover(ampBase + i,
                     (phaseMask & (1u << i)) ? GPIO_OVERRIDE_NORMAL
                                             : GPIO_OVERRIDE_LOW);
}



// ---- Arbitrary per-pulse sequence -----------------------------------------
//
// The PIO never cared where the numbers came from -- it just reads a table --
// so an explicit list of steps costs nothing but the parsing. `seqLen == 0`
// means "no table loaded", and elongation falls back to the geometric ratio it
// always used. Sharing ELONG_MAX_PULSES rather than inventing a second cap:
// the PIO table is the same table, so the same limit is the real one.
struct SeqStep {
  uint32_t t1_ns;
  uint32_t t2_ns;
  uint8_t  amp;      // 0..AMP_MASK, driven on GP18-20 during the PRIOR gap
};
static SeqStep  seqSteps[ELONG_MAX_PULSES];
static uint32_t seqLen = 0;

// ============================================================================
// Persistent settings — survive a power cycle
// ============================================================================
//
// The point is standalone use: wire up the knobs, dial in a train, unplug it,
// plug it back in tomorrow and it is still doing that. No serial, no dashboard.
//
// Stored in one emulated-EEPROM sector (really a 4 KB flash sector the core
// erases and rewrites whole). Two consequences shape everything below:
//
//   1. WRITING STOPS INTERRUPTS. EEPROM.commit() calls noInterrupts() and then
//      erases a sector, which is tens of milliseconds. The normal carrier+gate
//      path does not care at all -- it is pure PIO and needs no CPU. But the
//      elongation path re-arms its DMA from an IRQ, so a save while elongation
//      is running leaves the state machine waiting on an empty FIFO until
//      interrupts come back: a brief gap in the output, not a hang. Hence the
//      deferred, change-gated save below rather than writing on every click.
//
//   2. FLASH WEARS OUT. ~100k erase cycles. Saving per encoder detent would
//      burn that in an afternoon, so a save happens at most once per editing
//      session and only if the bytes actually differ.
static const uint32_t CFG_MAGIC    = 0x47504C53UL;   // 'GPLS'
static const uint16_t CFG_VERSION  = 5;   // 5: continuous frequency sweep
// Still one 4 KB flash sector -- the core erases and rewrites the whole sector
// either way, so this costs no extra wear and no extra write time, only a
// larger staging buffer during begin()/end().
static const uint32_t CFG_EE_SIZE  = 2048;
static const uint32_t CFG_SETTLE_MS = 5000;          // quiet time before saving

// Boot behaviour for the output enable, independent of the rest of the state.
// SAVED is what a bench instrument normally does; RUN is for a box that lives
// in a rig and should come straight back up pulsing after a power blip.
enum BootMode : uint8_t { BOOT_SAVED = 0, BOOT_RUN = 1, BOOT_OFF = 2 };

struct __attribute__((packed)) Settings {
  uint32_t magic;
  uint16_t version;
  uint16_t size;

  uint8_t  gateMode, sigSource, shapeMode, selParam;
  uint8_t  gateInvert, pulseInvert, outputEnabled, bootMode;
  uint8_t  autosave, elongActive, trainLen, seqLen;
  // interlockEnabled claims one of the two spare pad bytes rather than growing
  // the struct, so CFG_VERSION does not move and existing saved settings still
  // load. Old blobs zeroed the padding, and zero here means "interlock off" --
  // which is the right thing to inherit on a rig that has no sensor wired.
  // The *tripped* state is deliberately not persisted: a fault is not a
  // setting, and HV must never come back armed after a power cycle.
  uint8_t  phaseLen, phaseMode, interlockEnabled, _pad[1];

  uint32_t onCount, offCount;
  uint64_t gatePeriodNs;
  uint32_t gateDutyPpm;
  uint64_t carrierPeriodNs;
  uint32_t carrierDutyPpm;
  double   elongRatio;

  uint8_t  trainAmp[TRAIN_MAX];
  SeqStep  seqSteps[ELONG_MAX_PULSES];

  uint8_t  fsweepOn;
  uint32_t fsweepPeriodMs;
  uint32_t fsweepHiHz;

  // Spare, zero-filled. Every field added past the end changes sizeof and so
  // forces a CFG_VERSION bump, which throws away the operator's saved setup --
  // twice in a week is twice too often. Take bytes from here instead and the
  // layout, and therefore their settings, survive.
  uint8_t  phaseMask;
  uint8_t  reserved[23];

  uint32_t crc;                                     // must stay LAST
};

// The check that was missing when ELONG_MAX_PULSES was 25. Nothing at runtime
// notices Settings outgrowing the budget -- cfgWrite() memcpy's sizeof(s) into
// a CFG_EE_SIZE buffer, so an overflow is a silent stomp past the end of it,
// and the symptom would be corrupted settings rather than a build error.
// Raise CFG_EE_SIZE (up to 4096, one sector) if this ever fires.
static_assert(sizeof(Settings) <= CFG_EE_SIZE,
              "Settings no longer fits CFG_EE_SIZE -- raise it (max 4096)");

static bool     cfgAutosave = true;
static uint8_t  cfgBootMode = BOOT_SAVED;
static uint32_t cfgDirtyAt  = 0;      // 0 = clean
static bool     cfgReady    = false;  // suppresses dirty marks during boot/apply
static uint32_t cfgLastCrc  = 0;      // what is already in flash

static uint32_t cfgCrc32(const uint8_t *p, size_t n) {
  uint32_t c = 0xFFFFFFFFUL;
  for (size_t i = 0; i < n; i++) {
    c ^= p[i];
    for (int k = 0; k < 8; k++) c = (c >> 1) ^ (0xEDB88320UL & (-(int32_t)(c & 1)));
  }
  return ~c;
}

static void cfgCapture(Settings &s) {
  memset(&s, 0, sizeof(s));           // zero the padding too, or the CRC of two
  s.magic   = CFG_MAGIC;              // identical states can differ
  s.version = CFG_VERSION;
  s.size    = (uint16_t)sizeof(Settings);

  s.gateMode      = (uint8_t)gateMode;
  s.sigSource     = (uint8_t)sigSource;
  s.shapeMode     = (uint8_t)shapeMode;
  s.selParam      = selParam;
  s.gateInvert    = gateInvert ? 1 : 0;
  s.pulseInvert   = pulseInvert ? 1 : 0;
  s.outputEnabled = outputEnabled ? 1 : 0;
  s.bootMode      = cfgBootMode;
  s.autosave      = cfgAutosave ? 1 : 0;
  s.elongActive   = elong.active ? 1 : 0;
  s.trainLen      = (uint8_t)trainLen;
  s.phaseLen      = (uint8_t)phaseLen;
  s.phaseMask     = phaseMask;
  s.phaseMode     = phaseMode;
  s.interlockEnabled = interlockEnabled ? 1 : 0;
  s.fsweepOn       = fsweepOn ? 1 : 0;
  s.fsweepPeriodMs = fsweepPeriodMs;
  s.fsweepHiHz     = fsweepHiHz;
  s.seqLen        = (uint8_t)seqLen;

  s.onCount        = onCount;
  s.offCount       = offCount;
  s.gatePeriodNs   = gatePeriodNs;
  s.gateDutyPpm    = gateDutyPpm;
  s.carrierPeriodNs= carrierPeriodNs;
  s.carrierDutyPpm = carrierDutyPpm;
  s.elongRatio     = elong.ratio;

  for (uint32_t i = 0; i < TRAIN_MAX; i++) s.trainAmp[i] = trainAmp[i];
  for (uint32_t i = 0; i < ELONG_MAX_PULSES; i++) s.seqSteps[i] = seqSteps[i];

  s.crc = cfgCrc32((const uint8_t *)&s, sizeof(Settings) - sizeof(uint32_t));
}

// Everything here is range-checked on the way in. A corrupted or half-written
// blob that passed the CRC by luck must not be able to command a wild output --
// this is a generator wired to a cell, and "trust the flash" is not a policy.
static void cfgApply(const Settings &s) {
  gateMode    = s.gateMode ? MODE_COUNT : MODE_TIME;
  sigSource   = s.sigSource ? SRC_INT : SRC_EXT;
  shapeMode   = s.shapeMode ? SHAPE_T12 : SHAPE_FD;
  selParam    = s.selParam ? 1 : 0;
  gateInvert  = s.gateInvert;
  pulseInvert = s.pulseInvert;
  cfgBootMode = (s.bootMode <= BOOT_OFF) ? s.bootMode : BOOT_SAVED;
  cfgAutosave = s.autosave ? true : false;

  onCount  = (s.onCount  < COUNT_MIN) ? COUNT_MIN
           : (s.onCount  > COUNT_MAX) ? COUNT_MAX : s.onCount;
  offCount = (s.offCount < COUNT_MIN) ? COUNT_MIN
           : (s.offCount > COUNT_MAX) ? COUNT_MAX : s.offCount;

  gatePeriodNs = (s.gatePeriodNs < PERIOD_NS_MIN) ? PERIOD_NS_MIN
               : (s.gatePeriodNs > PERIOD_NS_MAX) ? PERIOD_NS_MAX : s.gatePeriodNs;
  carrierPeriodNs = (s.carrierPeriodNs < CARRIER_NS_MIN) ? CARRIER_NS_MIN
                  : (s.carrierPeriodNs > CARRIER_NS_MAX) ? CARRIER_NS_MAX
                  : s.carrierPeriodNs;
  gateDutyPpm = (s.gateDutyPpm < DUTY_PPM_MIN) ? DUTY_PPM_MIN
              : (s.gateDutyPpm > DUTY_PPM_MAX) ? DUTY_PPM_MAX : s.gateDutyPpm;
  carrierDutyPpm = (s.carrierDutyPpm < DUTY_PPM_MIN) ? DUTY_PPM_MIN
                 : (s.carrierDutyPpm > DUTY_PPM_MAX) ? DUTY_PPM_MAX : s.carrierDutyPpm;

  elong.ratio = (s.elongRatio >= ELONG_RATIO_MIN && s.elongRatio <= ELONG_RATIO_MAX)
              ? s.elongRatio : 8.0;
  elong.active = s.elongActive && elongPioReady;

  trainLen = (s.trainLen <= TRAIN_MAX) ? s.trainLen : 0;
  // Blobs written before the mask existed have a zeroed reserved[] block, so
  // a zero mask is not "no channels" -- it is "this save predates the field".
  // Rebuild it from the count, which is what it used to mean.
  {
    uint32_t pl = (s.phaseLen >= 1 && s.phaseLen <= AMP_BITS) ? s.phaseLen : 3;
    uint8_t  pm = (uint8_t)(s.phaseMask & AMP_MASK);
    setPhaseMask(pm ? pm : (uint8_t)((1u << pl) - 1u));
  }
  phaseMode = (s.phaseMode <= PH_SYNC) ? s.phaseMode : PH_OFF;

  // Restored armed-but-tripped, never armed-and-live. Whatever the enclosure
  // was doing when power went away is not knowable now, so the operator has to
  // look at it and say ARM.
  interlockEnabled = s.interlockEnabled ? true : false;
  interlockTripped = interlockEnabled;

  fsweepOn       = s.fsweepOn ? true : false;
  fsweepPeriodMs = (s.fsweepPeriodMs < FSWEEP_MS_MIN) ? FSWEEP_MS_MIN
                 : (s.fsweepPeriodMs > FSWEEP_MS_MAX) ? FSWEEP_MS_MAX
                 : s.fsweepPeriodMs;
  fsweepHiHz     = (s.fsweepHiHz < FSWEEP_HI_MIN) ? FSWEEP_HI_MIN
                 : (s.fsweepHiHz > FSWEEP_HI_MAX) ? FSWEEP_HI_MAX
                 : s.fsweepHiHz;
  for (uint32_t i = 0; i < TRAIN_MAX; i++)
    trainAmp[i] = (s.trainAmp[i] >= 1 && s.trainAmp[i] <= 100) ? s.trainAmp[i] : 100;

  seqLen = (s.seqLen <= ELONG_MAX_PULSES) ? s.seqLen : 0;
  for (uint32_t i = 0; i < ELONG_MAX_PULSES; i++) {
    seqSteps[i] = s.seqSteps[i];
    seqSteps[i].amp &= AMP_MASK;
  }
  // Validate only the steps actually in use. The slots past seqLen are zero
  // by construction (cfgCapture memsets the whole blob), so validating the
  // full array treated that zero padding as corruption and threw the table
  // away -- which meant any SEQ shorter than the maximum silently failed to
  // survive a power cycle, reported afterwards as an innocent "SEQ off".
  for (uint32_t i = 0; i < seqLen; i++) {
    if (!seqSteps[i].t1_ns || !seqSteps[i].t2_ns) { seqLen = 0; break; }
  }

  switch (cfgBootMode) {
    case BOOT_RUN: outputEnabled = true;  break;
    case BOOT_OFF: outputEnabled = false; break;
    default:       outputEnabled = s.outputEnabled ? true : false;
  }
}

static bool cfgWrite(Print &o) {
  Settings s;
  cfgCapture(s);
  if (s.crc == cfgLastCrc) { o.println("settings unchanged -- nothing written"); return true; }

  EEPROM.begin(CFG_EE_SIZE);
  uint8_t *dst = EEPROM.getDataPtr();
  memcpy(dst, &s, sizeof(s));
  const bool ok = EEPROM.commit();
  EEPROM.end();
  if (ok) cfgLastCrc = s.crc;
  o.println(ok ? "settings saved" : "ERROR: settings write failed");
  return ok;
}

// Returns true if a valid blob was found AND applied. Caller decides what to do
// with false -- on boot that means "keep the compiled-in defaults", which is
// exactly right for a board that has never been saved to.
static bool cfgRead(bool apply) {
  EEPROM.begin(CFG_EE_SIZE);
  Settings s;
  memcpy(&s, EEPROM.getConstDataPtr(), sizeof(s));
  EEPROM.end();

  if (s.magic != CFG_MAGIC) return false;
  if (s.version != CFG_VERSION) return false;    // layout changed: ignore, do not guess
  if (s.size != sizeof(Settings)) return false;
  const uint32_t want = cfgCrc32((const uint8_t *)&s, sizeof(Settings) - sizeof(uint32_t));
  if (want != s.crc) return false;

  cfgLastCrc = s.crc;
  if (apply) { cfgReady = false; cfgApply(s); cfgReady = true; }
  return true;
}

// Called from applyGate(), i.e. after anything that changes the waveform. Only
// arms a timer -- the write itself happens once the knobs go quiet, so a sweep
// across a decade is one save rather than sixty.
static void cfgTouch() {
  if (cfgReady && cfgAutosave) cfgDirtyAt = millis();
}

static void cfgPoll(Print &o) {
  if (!cfgDirtyAt || !cfgAutosave) return;
  if (millis() - cfgDirtyAt < CFG_SETTLE_MS) return;
  cfgDirtyAt = 0;
  Settings s;
  cfgCapture(s);
  if (s.crc == cfgLastCrc) return;               // nothing really changed
  EEPROM.begin(CFG_EE_SIZE);
  memcpy(EEPROM.getDataPtr(), &s, sizeof(s));
  if (EEPROM.commit()) cfgLastCrc = s.crc;
  EEPROM.end();
  (void)o;
}


// elongate_program always runs at clkdiv 1 (full sys clock, matching the
// gating SM's own "lowest latency" choice) rather than picking a divider the
// way genCycles() does for the free-running carrier. That caps any single
// phase at 0xFFFFFFFF cycles (~28.6 s at 150 MHz) -- fine for a feature whose
// whole point is a handful of pulses within one burst; a multi-second mute
// between elongated bursts is already well outside what this is for.
static uint32_t elongNsToCycles(uint64_t ns) {
  uint64_t fsys = clock_get_hz(clk_sys);
  uint64_t c = (ns * fsys) / 1000000000ULL;
  if (c > 0xFFFFFFFFULL) c = 0xFFFFFFFFULL;
  return (uint32_t)c;
}

// Pulses this burst will actually generate: onCount, floored at 1 and capped
// at what the table can hold. Both the width math and the reported per-pulse
// factor have to agree on this number or the two disagree at onCount > 25.
static uint32_t elongPulseCount() {
  uint32_t n = onCount;
  if (n < 1) n = 1;
  if (n > ELONG_MAX_PULSES) n = ELONG_MAX_PULSES;
  return n;
}

// Per-pulse multiplier that spreads elong.ratio evenly across the burst on a
// log scale, so pulse N lands at exactly `ratio` times pulse 1. A one-pulse
// burst has no span to divide up, so it stays flat.
static double elongPerPulseFactor() {
  if (!elong.active) return 1.0;     // engine may be up purely for PHASE
  uint32_t n = elongPulseCount();
  if (n < 2) return 1.0;
  return pow(elong.ratio, 1.0 / (double)(n - 1));
}

// Rebuilds the per-burst table from the current base T1/T2 (whatever ENC2/
// ENC3 last set -- elongArm() forces SHAPE_T12 so those knobs edit exactly
// this), the derived per-pulse factor, and onCount capped at ELONG_MAX_PULSES.
// Pulse 1 is the base pulse; each pulse after that is the previous one's
// width times that factor, T1 and T2 independently. Mute duration is offCount
// "carrier-equivalent" cycles at the BASE (unelongated) period -- offCount is
// a pulse count everywhere else in this sketch, so this keeps that meaning
// even though elongation generates its own pulses rather than counting an
// input. SHOT mode parks in mute forever, same trick the normal COUNT path
// uses via off=0xFFFFFFFF.
// Builds ONE burst's table into `dst`, with every T1 scaled by `t1Scale`.
// Returns the word count written.
//
// The scale is what makes per-train amplitude work. For an inductive primary
// the current at turn-off is V*T1/L, so narrowing every pulse in a burst by the
// same fraction attenuates that whole burst without touching its shape -- the
// elongation ratio, or a loaded SEQ envelope, still does exactly what it did,
// just at a lower level. T2 is deliberately NOT scaled: keeping the spacing put
// means the burst occupies the same time on screen at every amplitude, so the
// scope framing does not move as the ring cycles.
static uint32_t elongBuildInto(uint32_t *dst, double t1Scale, int32_t chanMask,
                               bool cycleMark) {
  // chanMask >= 0 pins every pulse in this burst to one channel code -- that is
  // PHASE mode, where the code IS the output. chanMask < 0 falls back to the
  // per-pulse codes a SEQ table carries, which is the tap-select case.
  //
  // cycleMark rides in the same word (bit 4 -> GP22) rather than being pushed
  // separately: it must land on exactly the same clock edge as the channel it
  // marks, and sharing the word is the only way to guarantee that.
  const bool table  = (seqLen > 0);
  uint32_t   n      = table ? seqLen : elongPulseCount();
  double     factor = table ? 1.0    : elongPerPulseFactor();

  double t1 = (double)currentT1Ns() * t1Scale;
  double t2 = (double)currentT2Ns();
  double baseNs = (double)currentT1Ns() + t2;    // unscaled: sets the mute

  // Order MUST match the program's own pull sequence: N, the gap mask, then N
  // triples of (channel mask, hi, lo), then mute LAST -- pulled once after the
  // on-phase loop exits, not second, or pulse 1 gets fed the mute count.
  uint32_t idx = 0;
  dst[idx++] = n - 1;
  // What the OUT group holds between pulses. The channel bits are 0 there (each
  // channel carries the real train, so it has to drop in the gaps) and the
  // marker is not, which is the whole reason this is a separate word rather
  // than the `mov osr, null` it replaced.
  dst[idx++] = cycleMark ? CYCLE_MASK : 0u;

  for (uint32_t i = 0; i < n; i++) {
    double hiNs = t1, loNs = t2;
    if (table) {
      hiNs = (double)seqSteps[i].t1_ns * t1Scale;   // the ring scales SEQ too
      loNs = (double)seqSteps[i].t2_ns;
    }
    uint32_t mask = (chanMask >= 0) ? ((uint32_t)chanMask & AMP_MASK)
                  : (table ? (uint32_t)(seqSteps[i].amp & AMP_MASK) : 0u);
    if (cycleMark) mask |= CYCLE_MASK;
    uint32_t hiCyc = elongNsToCycles((uint64_t)hiNs);
    uint32_t loCyc = elongNsToCycles((uint64_t)loNs);
    if (hiCyc < 4) hiCyc = 4;
    if (loCyc < 9) loCyc = 9;      // lo grew to +9 with the channel-clear pair
    dst[idx++] = mask;
    dst[idx++] = hiCyc - 4;        // hi is still +4: nothing was added inside it
    dst[idx++] = loCyc - 9;

    if (!table) { t1 *= factor; t2 *= factor; }
  }

  uint32_t muteCyc;
  if (shotMode) {
    muteCyc = 0xFFFFFFFFUL;
  } else {
    // A loaded table has no single base period to scale offCount by, so the
    // mute is offCount times the FIRST step. That keeps offCount meaning
    // "pulses of silence" everywhere rather than quietly becoming a duration.
    if (table) baseNs = (double)seqSteps[0].t1_ns + (double)seqSteps[0].t2_ns;
    muteCyc = elongNsToCycles((uint64_t)(baseNs * (double)offCount));
    if (muteCyc < 11) muteCyc = 11;
  }
  dst[idx++] = muteCyc - 11;   // 11, not 9: the gap-mask preamble is inside the
  return idx;                  // window the mute is measured over
}

// Rebuilds everything the DMA will read: the whole ring if one is armed,
// otherwise the single table. Every caller that changes what a burst should
// look like goes through here, so there is one place that knows which mode is
// live rather than a check at each call site.
static uint32_t cfgGcd(uint32_t a, uint32_t b) { while (b) { uint32_t t = a % b; a = b; b = t; } return a; }

static void elongBuildBank(uint8_t bank, uint32_t *tableLen, uint32_t *rLen) {
  const uint32_t tl = trainLen ? trainLen : 1;
  // SYNC fires every channel on every burst, so it adds no per-burst variation
  // and contributes 1 to the ring length -- only ROTATE walks the channels.
  const uint32_t pc = phaseCount();
  const uint32_t pl = (phaseMode == PH_ROTATE) ? (pc ? pc : 1) : 1;

  if (!trainLen && !phaseOn()) {         // neither sequence armed: one table
    *rLen = 0;
    // No cycle marker: with one table every burst is identical, so there is no
    // "burst 1" to point at. Marking them all would leave GP22 stuck high --
    // the marker only ever falls when a LATER burst rewrites it low.
    *tableLen = elongBuildInto(elongTableBank[bank], 1.0, -1, false);
    return;
  }
  // Both sequences advance once per burst but at different rates, so the
  // pattern only repeats after lcm(levels, channels) bursts. Build that many
  // tables and the IRQ needs nothing but an index.
  uint32_t n = (tl / cfgGcd(tl, pl)) * pl;
  if (n > RING_MAX) n = (tl > RING_MAX) ? RING_MAX : tl;   // pathological only
  *rLen = n;
  for (uint32_t k = 0; k < n; k++) {
    const double  scale = trainLen ? (double)trainAmp[k % tl] / 100.0 : 1.0;
    int32_t mask = -1;                                   // -1 = SEQ tap codes
    if (phaseMode == PH_ROTATE)    mask = (int32_t)nthChanBit(k);
    else if (phaseMode == PH_SYNC) mask = (int32_t)(phaseMask & AMP_MASK);
    // Only burst 1, and only when the pattern is actually longer than one burst
    // -- a 1-long ring has nothing to distinguish, and see the note above about
    // a marker that is never rewritten low.
    *tableLen = elongBuildInto(elongRingBank[bank][k], scale, mask, n > 1 && k == 0);
  }
}

// Cold start: build bank 0 and make it live. The DMA is stopped here.
static void elongBuildAll() {
  uint32_t len = 0, rl = 0;
  ePend = false;
  elongBuildBank(0, &len, &rl);
  eLive = 0;
  elongTable = elongTableBank[0];
  elongRing  = elongRingBank[0];
  elongTableLen = len;
  ringLen = rl;
  trainIdx = 0;
}

// Live edit: build the bank the DMA is NOT reading, then hand it to the IRQ,
// which switches at the next burst boundary. ePend is dropped first so an IRQ
// landing mid-build keeps playing the live bank instead of taking a half-built
// one; this runs on the same core as that IRQ, so once ePend reads false the
// live bank cannot change under us.
static void elongRetune() {
  ePend = false;
  __dmb();
  const uint8_t b = eLive ^ 1;
  uint32_t len = 0, rl = 0;
  elongBuildBank(b, &len, &rl);
  ePendLen = len; ePendRing = rl; ePendBank = b;
  __dmb();
  ePend = true;
}

// Fires once per burst (when the linear transfer completes, i.e. after the
// mute-count word has been consumed) -- points the DMA at the table the NEXT
// burst should use. Without a ring that is the same table every time; with one
// it advances and wraps, which is what makes an envelope span a train of bursts
// rather than resetting at every burst boundary.
//
// Pointer arithmetic only. The tables are prebuilt, so nothing here computes a
// width, and this stays safe to run in an interrupt that fires once per burst.
static void elongDmaIrqHandler() {
  dma_hw->ints0 = 1u << elongDmaChan;
  if (ePend) {
    // A retune is ready: switch banks here, between bursts. The pattern keeps
    // its place -- burst k+1 of the new ring follows burst k of the old -- so
    // an edit during ROTATE does not snap the rotation back to channel 1.
    ePend = false;
    const uint8_t b = ePendBank;
    eLive = b;
    elongTable    = elongTableBank[b];
    elongRing     = elongRingBank[b];
    elongTableLen = ePendLen;
    ringLen       = ePendRing;
    if (trainIdx >= ringLen) trainIdx = ringLen ? ringLen - 1 : 0;
  }
  const uint32_t *next = elongTable;
  if (ringLen) {
    uint32_t i = trainIdx + 1;
    if (i >= ringLen) i = 0;
    trainIdx = i;
    next = elongRing[i];
  }
  dma_channel_set_trans_count(elongDmaChan, elongTableLen, false);
  dma_channel_set_read_addr(elongDmaChan, next, true);
}

static void elongStart() {
  elongBuildAll();

  pio_gpio_init(pioElong, PIN_GATE_OUT);
  pio_gpio_init(pioElong, PIN_GATED_OUT);
  pio_sm_set_consecutive_pindirs(pioElong, smElong, PIN_GATE_OUT, 2, true);

  // Amplitude select and the cycle marker share one OUT group; SET and OUT are
  // independent pin groups on one SM, so this needs no extra state machine.
  // Bit 3 (ampBase+3 = GP21) is skipped on purpose -- handing that pad to PIO
  // would take it away from the mode button. Its pindir is still set here, but
  // a pindir on a pad whose function is SIO does nothing.
  for (uint i = 0; i < AMP_BITS; i++) pio_gpio_init(pioElong, ampBase + i);
  pio_gpio_init(pioElong, cyclePin());
  pio_sm_set_consecutive_pindirs(pioElong, smElong, ampBase, OUT_BITS, true);

  pio_sm_config c = pio_get_default_sm_config();
  sm_config_set_wrap(&c, offElong, offElong + elongate_program.length - 1);
  sm_config_set_set_pins(&c, PIN_GATE_OUT, 2);
  sm_config_set_out_pins(&c, ampBase, OUT_BITS);
  // Shift right so `out pins, n` takes the low n bits of the pushed word, and
  // NO autopull -- every pull in this program is explicit and ordered, and an
  // autopull firing between them would desynchronise the whole table.
  sm_config_set_out_shift(&c, true, false, 32);
  // ISR holds the gap mask for a whole burst, so autopush must stay off -- it
  // is a scratch register here, not an input path, and nothing ever reads the
  // RX FIFO. (MOV ISR does not trigger autopush anyway, which only fires after
  // an IN; this is belt-and-braces against a future IN being added.)
  sm_config_set_in_shift(&c, true, false, 32);
  sm_config_set_clkdiv_int_frac(&c, 1, 0);

  pio_sm_init(pioElong, smElong, offElong, &c);
  pio_sm_set_enabled(pioElong, smElong, true);

  dma_channel_config dc = dma_channel_get_default_config(elongDmaChan);
  channel_config_set_transfer_data_size(&dc, DMA_SIZE_32);
  channel_config_set_read_increment(&dc, true);
  channel_config_set_write_increment(&dc, false);
  channel_config_set_dreq(&dc, pio_get_dreq(pioElong, smElong, true));
  dma_channel_configure(elongDmaChan, &dc, &pioElong->txf[smElong],
                        ringLen ? elongRing[0] : elongTable,
                        elongTableLen, true);               // trigger now

  // Same reasoning as the normal path: gpio_set_function() inside
  // pio_gpio_init() above just wiped this, so it must be set after.
  gpio_set_outover(PIN_GATED_OUT,
                   pulseInvert ? GPIO_OVERRIDE_INVERT : GPIO_OVERRIDE_NORMAL);
  applyChanMaskPads();
}

// Arms elongation: forces the preconditions it needs (COUNT+INT) and the
// carrier-edit mode that makes ENC2/ENC3 mean "base T1/T2", then lets
// applyGate() notice elong.active and route to elongStart(). Re-arming
// (button pressed again, or a param changed while already active) just
// rebuilds the table with whatever's current -- there is no separate "was it
// ever configured" state to track, unlike the old ramp button.
// Preconditions the elongation state machine needs, without asserting that you
// want elongation SHAPING. PHASE uses this: it needs the engine, not the ratio.
static void phaseArm() {
  if (!elongPioReady) return;
  shapeMode = SHAPE_T12;
  sigSource = SRC_INT;
  gateMode  = MODE_COUNT;
  applyGate();
}

static void elongArm() {
  if (!elongPioReady) return;
  elong.active = true;
  shapeMode     = SHAPE_T12;
  sigSource     = SRC_INT;
  gateMode      = MODE_COUNT;
  applyGate();
}

// Reverts to a flat train of the base pulses -- i.e. exactly the normal
// carrier+gate path, since that's what already runs whenever elong.active is
// false. No separate "flat mode" to implement.
static void elongDisarm() {
  elong.active = false;
  applyGate();          // PHASE keeps the engine up; the train just goes flat
}

// ---- T1/T2 sweep ramp (RAMP1/RAMP2) ----------------------------------------
// Steps the carrier's own T1/T2 between BURSTS over many seconds -- a
// resonance sweep, distinct from the per-pulse elongation above which
// reshapes pulses WITHIN one burst. Kept under its original name/commands.

// carrierPeriodNs * dutyPpm maxes out around 1e9 * 1e6 = 1e15, comfortably
// inside uint64_t (~1.8e19) -- plain 64-bit math, no overflow risk.
static uint64_t currentT1Ns() { return (carrierPeriodNs * (uint64_t)carrierDutyPpm) / 1000000ULL; }
static uint64_t currentT2Ns() { return carrierPeriodNs - currentT1Ns(); }

static void applyT1T2(uint64_t t1Ns, uint64_t t2Ns) {
  uint64_t period = t1Ns + t2Ns;
  if (period < CARRIER_NS_MIN) period = CARRIER_NS_MIN;
  if (period > CARRIER_NS_MAX) period = CARRIER_NS_MAX;
  carrierPeriodNs = period;
  uint32_t ppm = (uint32_t)((t1Ns * 1000000ULL) / period);
  if (ppm < DUTY_PPM_MIN) ppm = DUTY_PPM_MIN;
  if (ppm > DUTY_PPM_MAX) ppm = DUTY_PPM_MAX;
  carrierDutyPpm = ppm;
  applyGate();
}

// How long one full burst takes, in ns -- the unit "every N bursts" counts in.
// COUNT mode computes it from the carrier directly (integer, exact, no float
// round-trip); TIME mode's burst period is the gate generator's own, set by a
// separate PIO SM and independent of the carrier's own mark/space.
static uint64_t burstPeriodNs() {
  if (gateMode == MODE_COUNT) {
    uint64_t total = (uint64_t)onCount + offCount;
    return total * carrierPeriodNs;
  }
  return gatePeriodNs;
}

// Multiply before dividing: at a fast carrier (period in the hundreds of ns)
// with a large bursts-per-step, dividing burstPeriodNs by 1000 first can floor
// to zero and silently step every poll instead of waiting the intended count.
static uint64_t rampIntervalUs(uint32_t burstsPerStep) {
  uint64_t bp = burstPeriodNs();
  if (!bp) return 100000ULL;            // no burst rate yet -- fall back to 100 ms
  uint64_t us = (bp * (uint64_t)burstsPerStep) / 1000ULL;
  return us ? us : 1ULL;
}

// Arms a ramp with an explicit configuration -- shared by the RAMP1/RAMP2
// command (fresh values typed in) and the elongation pushbutton (re-arming
// with whatever was configured last). Capturing startNs from the CURRENT
// T1/T2 here, not from whatever the caller remembers, is what makes a wrap
// restart from wherever the value actually sits instead of drifting from a
// stale snapshot.
static void armRamp(RampCfg &r, bool isT1, int64_t stepNs, uint32_t bursts,
                    uint64_t limitNs, bool wrap) {
  sigSource = SRC_INT;         // ramping the carrier implies SRC INT, same as C/CD
  uint64_t t1 = currentT1Ns(), t2 = currentT2Ns();
  r.startNs       = isT1 ? t1 : t2;
  r.stepNs        = stepNs;
  r.burstsPerStep = bursts;
  r.limitNs       = limitNs;
  r.wrap          = wrap;
  r.active        = true;
  r.nextStepAtUs  = time_us_64() + rampIntervalUs(bursts);
}

static void rampStep(RampCfg &r, bool isT1) {
  uint64_t t1 = currentT1Ns(), t2 = currentT2Ns();
  uint64_t &target = isT1 ? t1 : t2;
  int64_t next = (int64_t)target + r.stepNs;
  bool reachedLimit = (r.stepNs >= 0) ? (next >= (int64_t)r.limitNs)
                                      : (next <= (int64_t)r.limitNs);
  if (reachedLimit) {
    if (r.wrap) target = r.startNs;
    else { target = r.limitNs; r.active = false; }   // hold at the limit; done
  } else {
    target = (uint64_t)next;
  }
  applyT1T2(t1, t2);
}

// Called from loop(). Nothing here is timing-critical -- a step landing a
// fraction late just makes that step's dwell one poll-cycle longer, which is
// invisible against a "every N bursts" cadence.
// 1 kHz update. At a 1 s sweep that is ~20 Hz of travel per step, and because
// each step is a divider write rather than a restart, the output slides rather
// than stepping -- the granularity shows up as rate, not as edges.
static void fsweepPoll() {
  if (!fsweepOn || !pioReady || !outputLive()) return;
  static uint64_t lastUs = 0;
  const uint64_t now = time_us_64();
  if (now - lastUs < 1000) return;
  lastUs = now;

  const uint64_t perUs = (uint64_t)fsweepPeriodMs * 1000ULL;
  const double   ph    = (double)((now - fsweepT0Us) % perUs) / (double)perUs;
  fsweepRising = (ph < 0.5);
  // Triangle, so the band is swept up and then back down at the same rate --
  // a sawtooth would snap from the ceiling to zero and ring everything on the
  // bench at the flyback.
  fsweepApply(fsweepRising ? ph * 2.0 : (1.0 - ph) * 2.0);
  gpio_put(PIN_GATE_OUT, fsweepRising ? 1 : 0);
}

static void pollRamp() {
  uint64_t now = time_us_64();
  if (ramp1.active && (int64_t)(now - ramp1.nextStepAtUs) >= 0) {
    rampStep(ramp1, true);
    ramp1.nextStepAtUs = now + rampIntervalUs(ramp1.burstsPerStep);
  }
  if (ramp2.active && (int64_t)(now - ramp2.nextStepAtUs) >= 0) {
    rampStep(ramp2, false);
    ramp2.nextStepAtUs = now + rampIntervalUs(ramp2.burstsPerStep);
  }
}

// ============================================================================
// Input frequency counter (PWM slice, hardware)
// ============================================================================
//
// PWM channel B can clock its slice from rising edges on its pin instead of
// from sys_clk, making the slice a free 16-bit pulse counter. The CPU only
// reads a register occasionally — no per-edge interrupt, which is what made
// this awkward on the AVR. GPIO inputs reach every peripheral at once
// regardless of FUNCSEL, so PIO still sees GP3 while the pad is set to PWM.

static uint     freqSlice    = 0;
static uint16_t freqLast     = 0;
static uint32_t freqAccum    = 0;
static uint32_t freqWinStart = 0;

static void freqCounterInit() {
  gpio_set_function(PIN_SIG_IN, GPIO_FUNC_PWM);
  freqSlice = pwm_gpio_to_slice_num(PIN_SIG_IN);

  pwm_config cfg = pwm_get_default_config();
  pwm_config_set_clkdiv_mode(&cfg, PWM_DIV_B_RISING);
  pwm_config_set_clkdiv(&cfg, 1.0f);
  pwm_config_set_wrap(&cfg, 65535);
  pwm_init(freqSlice, &cfg, true);

  freqLast     = (uint16_t)pwm_get_counter(freqSlice);
  freqWinStart = millis();
}

// Sampled every 50 ms so the 16-bit counter cannot wrap below 1.31 MHz, then
// averaged over 500 ms for ~2 Hz resolution.
static void freqPoll() {
  static uint32_t lastSample = 0;
  uint32_t now = millis();
  if (now - lastSample < 50) return;
  lastSample = now;

  uint16_t c = (uint16_t)pwm_get_counter(freqSlice);
  freqAccum += (uint16_t)(c - freqLast);
  freqLast = c;

  uint32_t win = now - freqWinStart;
  if (win >= 500) {
    measuredHz   = (float)freqAccum * 1000.0f / (float)win;
    freqAccum    = 0;
    freqWinStart = now;
  }
}

// ============================================================================
// Readout — everything writes to a Print so serial and HTTP share one path
// ============================================================================

// Accumulates Print output into a String for the HTTP handlers.
class StringPrint : public Print {
public:
  String s;
  size_t write(uint8_t c) override { s += (char)c; return 1; }
  size_t write(const uint8_t *b, size_t n) override {
    s.concat((const char *)b, n); return n;
  }
};

static void printU64(Print &o, uint64_t v) {
  char b[24];
  snprintf(b, sizeof(b), "%llu", (unsigned long long)v);
  o.print(b);
}

static void printState(Print &o) {
  uint64_t fsys = clock_get_hz(clk_sys);

  o.println("=== GATED PULSE (Pico 2 W / PIO) ===");
  o.println("firmware  : " FW_VERSION " (" FW_BUILD ")");
  o.print  ("mode      : ");
  o.println(gateMode == MODE_COUNT ? "COUNT (PIO counts input pulses)"
                                   : "TIME  (PIO gate generator)");
  o.print  ("output    : ");
  o.print  (outputEnabled ? "enabled" : "DISABLED");
  if (interlockTripped) o.print(" (INTERLOCK OPEN - nothing driven)");
  o.print  ("   gate: ");
  o.print  (gateInvert ? "inverted" : "normal");
  o.print  ("   pulses: ");
  o.println(pulseInvert ? "active-low" : "active-high");
  o.print  ("editing   : ");
  if (gateMode == MODE_COUNT) o.println(selParam ? "OFF pulses" : "ON pulses");
  else                        o.println(selParam ? "DUTY"       : "PERIOD");
  o.print  ("carrier ctl: ");
  o.print  (shapeMode == SHAPE_T12 ? "T1/T2 independent" : "freq/duty");
  o.print  ("   elongation: ");
  if (elong.active) {
    o.print("ON, ratio "); o.print(elong.ratio, 4);
    o.print("x over "); o.print(elongPulseCount()); o.print(" pulses (");
    o.print(elongPerPulseFactor(), 4); o.println("/pulse)");
  } else {
    o.println("off");
  }
  o.print  ("   sweep    : ");
  o.println((ramp1.active || ramp2.active) ? "ON" : "off");

  o.print("source    : ");
  if (sigSource == SRC_INT) {
    o.print("INTERNAL carrier on GP2 — ");
    o.print(sourceHz(), 3); o.print(" Hz, ");
    o.print((double)carrierDutyPpm / 10000.0, 3); o.println(" % duty");
    o.print("  PIO car : clkdiv "); o.print(achCarDiv);
    o.print(" hi="); o.print(achCarHi);
    o.print(" lo="); o.print(achCarLo);
    o.print("  (asked "); o.print(1e9 / (double)carrierPeriodNs, 3);
    o.println(" Hz)");
    if (ramp1.active) {
      o.print("  T1 ramp: now "); o.print(currentT1Ns() / 1000.0, 3);
      o.print(" us, step "); o.print(ramp1.stepNs / 1000.0, 3);
      o.print(" us / "); o.print(ramp1.burstsPerStep); o.print(" burst(s), limit ");
      o.print(ramp1.limitNs / 1000.0, 3);
      o.println(ramp1.wrap ? " us, WRAP" : " us, STOP");
    }
    if (ramp2.active) {
      o.print("  T2 ramp: now "); o.print(currentT2Ns() / 1000.0, 3);
      o.print(" us, step "); o.print(ramp2.stepNs / 1000.0, 3);
      o.print(" us / "); o.print(ramp2.burstsPerStep); o.print(" burst(s), limit ");
      o.print(ramp2.limitNs / 1000.0, 3);
      o.println(ramp2.wrap ? " us, WRAP" : " us, STOP");
    }
  } else {
    o.println("EXTERNAL sig gen on GP3");
  }

  if (gateMode == MODE_COUNT) {
    uint64_t total = (uint64_t)onCount + offCount;
    double   shz   = sourceHz();
    o.print("ON  pulses: "); o.print(onCount);
    if (effectiveBurstPulses() != onCount) {
      o.print("  ** only "); o.print(effectiveBurstPulses());
      o.print(" emitted -- the channel/elongation engine streams a table capped at ");
      o.print(ELONG_MAX_PULSES); o.print(" pulses");
    }
    o.println();
    o.print("OFF pulses: "); o.println(offCount);
    o.print("period    : "); printU64(o, total); o.println(" input pulses");
    o.print("duty      : ");
    o.print(100.0 * (double)onCount / (double)total, 4); o.println(" %");
    if (shz > 0) {
      o.print("burst rate: "); o.print(shz / (double)total, 4); o.println(" Hz");
      o.print("burst len : "); o.print((double)onCount * 1e6 / shz, 3); o.println(" us");
    }
  } else {
    double perUs = (double)gatePeriodNs / 1000.0;
    double duty  = (double)gateDutyPpm / 10000.0;
    double shz   = sourceHz();
    o.print("period    : "); o.print(perUs, 3);
    o.print(" us  ("); o.print(1e9 / (double)gatePeriodNs, 4); o.println(" Hz)");
    o.print("duty      : "); o.print(duty, 4); o.println(" %");
    o.print("open width: "); o.print(perUs * duty / 100.0, 3); o.println(" us");

    double tickNs = 1e9 * (double)achGenDiv / (double)fsys;
    double achPer = (double)(achHiCyc + achLoCyc) * tickNs;
    o.print("PIO gate  : clkdiv "); o.print(achGenDiv);
    o.print("  hi="); o.print(achHiCyc);
    o.print("  lo="); o.print(achLoCyc);
    o.print("  tick="); o.print(tickNs, 3); o.println(" ns");
    o.print("achieved  : "); o.print(achPer / 1000.0, 4);
    o.print(" us period, ");
    o.print(100.0 * achHiCyc / (double)(achHiCyc + achLoCyc), 4);
    o.println(" % duty");
    if (shz > 0) {
      o.print("pulses/brst: ~"); o.println(perUs * duty / 100.0 * shz / 1e6, 2);
    }
  }

  o.print("input freq: ");
  if (sigSource == SRC_INT) { o.print(sourceHz(), 3); o.println(" Hz (internal, exact)"); }
  else if (measuredHz > 0)  { o.print(measuredHz, 1); o.println(" Hz (hardware counter)"); }
  else                      { o.println("no input detected on GP3"); }

  o.print("pio       : gating pio"); o.print(pio_get_index(pioGate));
  o.print(" sm"); o.print(smGate); o.print(" @"); o.print(offGating);
  o.print(",  gen pio"); o.print(pio_get_index(pioGen));
  o.print(" sm"); o.print(smGen); o.print("/sm"); o.print(smCarrier);
  o.print(" @"); o.println(offGen);
  o.print("sys clock : "); printU64(o, fsys / 1000000); o.println(" MHz");
  o.print("wifi      : ");
  if (WiFi.status() == WL_CONNECTED) {
    o.print(WiFi.SSID()); o.print("  http://"); o.print(WiFi.localIP());
    o.print("/  ("); o.print(MDNS_NAME); o.println(".local)");
  } else {
    o.println(strlen(WIFI_SSID) ? "not connected" : "disabled (no secrets.h)");
  }
}

// True when the elongation state machine -- not the normal carrier+gate pair --
// is the thing generating pulses. Mirrors the routing test in applyGate().
// It matters for REPORTING because that engine streams a prebuilt table capped
// at ELONG_MAX_PULSES, so a longer burst is silently shortened.
static inline bool elongEngineActive() {
  return (elong.active || phaseOn()) && elongPioReady
      && sigSource == SRC_INT && gateMode == MODE_COUNT;
}

// The burst length actually emitted, which is NOT always the one you asked
// for. Reporting onCount unconditionally meant `ON 40` in a phase mode showed
// 40 everywhere while the hardware emitted 25 -- an instrument disagreeing
// with itself, which is worse than one with a limit.
static inline uint32_t effectiveBurstPulses() {
  if (seqLen > 0 && elongEngineActive()) return seqLen;
  return elongEngineActive() ? elongPulseCount() : onCount;
}

// ---- Machine-readable status ---------------------------------------------
// One line of JSON so host tooling never has to scrape the human readout.
static void printJson(Print &o) {
  double   shz   = sourceHz();
  uint64_t total = (uint64_t)onCount + offCount;

  o.print("{\"ok\":1");
  o.print(",\"fw\":\"" FW_VERSION "\",\"build\":\"" FW_BUILD "\"");
  // 1 = edits retune the running engine; 0 = no spare PIO, every edit restarts
  o.print(",\"live_retune\":"); o.print(liveReady && liveOn ? 1 : 0);
  o.print(",\"mode\":\"");  o.print(gateMode == MODE_COUNT ? "COUNT" : "TIME");
  o.print("\",\"src\":\""); o.print(sigSource == SRC_INT ? "INT" : "EXT");
  o.print("\",\"enabled\":");    o.print(outputEnabled ? 1 : 0);
  // "enabled" stays the operator's intent; "live" is whether anything is
  // actually coming out. Host tooling that arms a scope wants live.
  o.print(",\"live\":");         o.print(outputLive() ? 1 : 0);
  o.print(",\"interlock\":");    o.print(interlockEnabled ? 1 : 0);
  o.print(",\"interlock_closed\":"); o.print(interlockClosed() ? 1 : 0);
  o.print(",\"interlock_tripped\":"); o.print(interlockTripped ? 1 : 0);
  o.print(",\"interlock_trips\":");   o.print(interlockTrips);
  o.print(",\"interlock_pin\":");     o.print(PIN_INTERLOCK);
  o.print(",\"gate_invert\":");  o.print(gateInvert ? 1 : 0);
  o.print(",\"pulse_invert\":"); o.print(pulseInvert ? 1 : 0);
  o.print(",\"editing\":\"");
  if (gateMode == MODE_COUNT) o.print(selParam ? "OFF" : "ON");
  else                        o.print(selParam ? "DUTY" : "PERIOD");

  o.print("\",\"shape\":\""); o.print(shapeMode == SHAPE_T12 ? "T12" : "FD");
  o.print("\",\"elongation\":"); o.print(elong.active ? 1 : 0);
  o.print(",\"elong_ratio\":"); o.print(elong.ratio, 4);
  // Still published, and still means exactly what it always did -- the
  // per-pulse multiplier. It is now derived rather than stored, so the
  // consumers that mirror elongBuildInto() (the MCP server's predicted
  // waveform, the dashboard readout) keep composing without knowing the knob
  // moved up a level.
  o.print(",\"elong_factor\":"); o.print(elongPerPulseFactor(), 6);
  o.print(",\"elong_pulses\":"); o.print(elongPulseCount());
  o.print(",\"sweep\":"); o.print((ramp1.active || ramp2.active) ? 1 : 0);
  // The loaded envelope, if any. Emitted in full rather than as a length:
  // every consumer that predicts the waveform (the MCP server's expected
  // trace, the dashboard chart) needs the actual widths, and a table is the
  // one case where they cannot be derived from ratio + count.
  // Whether the elongation state machine actually got claimed. ELONGATE, SEQ
  // and TRAIN all silently do nothing without it, and "nothing happened" is a
  // miserable thing to debug from the outside.
  o.print(",\"elong_pio\":"); o.print(elongPioReady ? 1 : 0);
  o.print(",\"autosave\":"); o.print(cfgAutosave ? 1 : 0);
  o.print(",\"boot_mode\":\"");
  o.print(cfgBootMode == BOOT_RUN ? "RUN" : cfgBootMode == BOOT_OFF ? "OFF" : "SAVED");
  o.print("\",\"saved\":"); o.print(cfgLastCrc ? 1 : 0);
  o.print(",\"phase_len\":"); o.print(phaseLen);
  o.print(",\"phase_mask\":"); o.print(phaseMask & AMP_MASK);
  o.print(",\"phase_mode\":\"");
  o.print(phaseMode == PH_SYNC ? "SYNC" : phaseMode == PH_ROTATE ? "ROTATE" : "OFF");
  o.print("\"");
  o.print(",\"ring_len\":"); o.print(ringLen);
  o.print(",\"cycle_pin\":"); o.print(cyclePin());
  o.print(",\"cycle_on\":");  o.print(ringLen > 1 ? 1 : 0);
  o.print(",\"train_len\":"); o.print(trainLen);
  if (trainLen) {
    o.print(",\"train\":[");
    for (uint32_t i = 0; i < trainLen; i++) {
      if (i) o.print(",");
      o.print(trainAmp[i]);
    }
    o.print("]");
  }
  o.print(",\"seq_len\":"); o.print(seqLen);
  if (seqLen) {
    o.print(",\"seq\":[");
    for (uint32_t i = 0; i < seqLen; i++) {
      if (i) o.print(",");
      o.print("{\"t1_ns\":"); o.print(seqSteps[i].t1_ns);
      o.print(",\"t2_ns\":"); o.print(seqSteps[i].t2_ns);
      o.print(",\"amp\":");   o.print(seqSteps[i].amp);
      o.print("}");
    }
    o.print("]");
  }

  o.print(",\"on\":");  o.print(onCount);
  o.print(",\"off\":");   o.print(offCount);
  o.print(",\"period_ns\":");           printU64(o, gatePeriodNs);
  o.print(",\"duty_ppm\":");            o.print(gateDutyPpm);
  o.print(",\"carrier_ns\":");          printU64(o, carrierPeriodNs);
  o.print(",\"carrier_duty_ppm\":");    o.print(carrierDutyPpm);

  o.print(",\"source_hz\":");   o.print(shz, 4);
  o.print(",\"measured_hz\":"); o.print(measuredHz, 2);
  o.print(",\"sys_hz\":");      printU64(o, clock_get_hz(clk_sys));

  o.print(",\"gate_div\":"); o.print(achGenDiv);
  o.print(",\"gate_hi\":");  o.print(achHiCyc);
  o.print(",\"gate_lo\":");  o.print(achLoCyc);
  o.print(",\"car_div\":");  o.print(achCarDiv);
  o.print(",\"car_hi\":");   o.print(achCarHi);
  o.print(",\"car_lo\":");   o.print(achCarLo);

  // Derived, so callers do not duplicate the maths.
  if (gateMode == MODE_COUNT) {
    o.print(",\"burst_pulses\":"); o.print(effectiveBurstPulses());
    if (effectiveBurstPulses() != onCount) {
      o.print(",\"burst_clamped\":1,\"burst_requested\":"); o.print(onCount);
    }
    if (shz > 0) {
      o.print(",\"burst_hz\":"); o.print(shz / (double)total, 6);
      o.print(",\"burst_us\":"); o.print((double)onCount * 1e6 / shz, 4);
    }
  } else {
    double openUs = (double)gatePeriodNs / 1000.0 * (double)gateDutyPpm / 1e6;
    o.print(",\"burst_hz\":"); o.print(1e9 / (double)gatePeriodNs, 6);
    o.print(",\"burst_us\":"); o.print(openUs, 4);
    if (shz > 0) { o.print(",\"burst_pulses\":"); o.print(openUs * shz / 1e6, 2); }
  }

  o.print(",\"fsweep\":");        o.print(fsweepOn ? 1 : 0);
  o.print(",\"fsweep_ms\":");     o.print(fsweepPeriodMs);
  o.print(",\"fsweep_hi_hz\":");  o.print((uint32_t)(fsweepTopHz() + 0.5));
  o.print(",\"fsweep_hz\":");     o.print(fsweepNowHz, 2);
  o.print(",\"fsweep_dir\":\"");  o.print(fsweepRising ? "up" : "down");
  o.print("\",\"ramp1_active\":"); o.print(ramp1.active ? 1 : 0);
  if (ramp1.active) {
    o.print(",\"ramp1_t1_ns\":");    printU64(o, currentT1Ns());
    o.print(",\"ramp1_step_ns\":");  o.print((double)ramp1.stepNs, 0);
    o.print(",\"ramp1_bursts\":");   o.print(ramp1.burstsPerStep);
    o.print(",\"ramp1_limit_ns\":"); printU64(o, ramp1.limitNs);
    o.print(",\"ramp1_wrap\":");     o.print(ramp1.wrap ? 1 : 0);
  }
  o.print(",\"ramp2_active\":"); o.print(ramp2.active ? 1 : 0);
  if (ramp2.active) {
    o.print(",\"ramp2_t2_ns\":");    printU64(o, currentT2Ns());
    o.print(",\"ramp2_step_ns\":");  o.print((double)ramp2.stepNs, 0);
    o.print(",\"ramp2_bursts\":");   o.print(ramp2.burstsPerStep);
    o.print(",\"ramp2_limit_ns\":"); printU64(o, ramp2.limitNs);
    o.print(",\"ramp2_wrap\":");     o.print(ramp2.wrap ? 1 : 0);
  }

  o.print(",\"shot\":");       o.print(shotMode ? 1 : 0);
  o.print(",\"running\":");    o.print(runUntilMs ? 1 : 0);
  o.print(",\"run_len_ms\":");  o.print(runLenMs);
  o.print(",\"run_left_ms\":");
  o.print(runUntilMs ? (int32_t)(runUntilMs - millis()) : 0);
  o.print(",\"wifi\":");
  if (WiFi.status() == WL_CONNECTED) {
    o.print("\""); o.print(WiFi.localIP()); o.print("\"");
  } else {
    o.print("null");
  }
  o.println("}");
}

// ---- Bring-up diagnostic --------------------------------------------------
// Answers the questions you actually have when nothing comes out: is there a
// signal on the pin, is the PWM counter seeing it, and is the gating state
// machine running or parked on a wait?
// Percentage of a 200 ms window a pin spends high. One gpio_get() cannot tell
// "low at this instant" from "dead", which is exactly the ambiguity that costs
// an hour at the bench: a channel that is rotating reads its share, one that is
// stuck reads 0 or 100.
//
// The window is a whole number of patterns only by luck, so the figure is
// quantised by however many bursts fall inside it -- at 10 kHz / ON 10 / OFF 90
// a 50 ms window read a true 33% as either 20% or 40%. 200 ms keeps that error
// small enough to not mislead while staying an interactive command's worth of
// blocking (four pins, so ~0.8 s).
static void printPinDuty(Print &o, const char *label, uint pin) {
  uint32_t hi = 0, n = 0;
  uint32_t t0 = micros();
  while ((uint32_t)(micros() - t0) < 200000) { if (gpio_get(pin)) hi++; n++; }
  o.print(label); o.print(" GP"); o.print(pin); o.print(" : ");
  o.print(n ? (100.0 * hi) / n : 0.0, 1); o.println("% of 200ms high");
}

// What the OTA staging filesystem holds. An update is sized by its FREE space,
// so a leftover image there is exactly what makes the next upload die partway.
static void printOtaFs(Print &o) {
  if (!LittleFS.begin()) { o.println("ota fs    : not mounted"); return; }
  FSInfo i;
  LittleFS.info(i);
  o.print("ota fs    : "); o.print((uint32_t)(i.usedBytes / 1024)); o.print(" KB used of ");
  o.print((uint32_t)(i.totalBytes / 1024)); o.print(" KB");
  Dir d = LittleFS.openDir("/");
  while (d.next()) { o.print("  ["); o.print(d.fileName()); o.print(" ");
                     o.print((uint32_t)d.fileSize()); o.print("]"); }
  o.println();
}

static void printDiag(Print &o) {
  const uint inPin = (sigSource == SRC_INT) ? PIN_CARRIER : PIN_SIG_IN;
  printOtaFs(o);

  uint32_t edges = 0, hi = 0, samples = 0;
  bool prev = gpio_get(inPin);
  uint32_t t0 = micros();
  while ((uint32_t)(micros() - t0) < 5000) {
    bool c = gpio_get(inPin);
    if (c && !prev) edges++;
    if (c) hi++;
    samples++;
    prev = c;
  }
  uint32_t elapsed = micros() - t0;

  uint16_t p0 = (uint16_t)pwm_get_counter(freqSlice);
  uint32_t pc0 = pio_sm_get_pc(pioGate, smGate);
  delayMicroseconds(5000);
  uint16_t pwmDelta = (uint16_t)((uint16_t)pwm_get_counter(freqSlice) - p0);
  uint32_t pc1 = pio_sm_get_pc(pioGate, smGate);

  o.println("=== DIAG ===");
  o.print("input pin      : GP"); o.print(inPin);
  o.println(sigSource == SRC_INT ? "  (internal carrier)" : "  (external)");
  o.print("  CPU-sampled  : "); o.print(edges);
  o.print(" rising edges in "); o.print(elapsed); o.print(" us  -> ~");
  o.print(elapsed ? (double)edges * 1e6 / elapsed : 0.0, 1); o.println(" Hz");
  o.print("  duty seen    : ");
  o.print(samples ? 100.0 * hi / samples : 0.0, 1); o.println(" %");
  o.print("  PWM counter  : "); o.print(pwmDelta);
  o.println(" edges in 5000 us on GP3");
  o.println("  (PWM should track GP3 even though PIO also reads it — RP2350");
  o.println("   routes each pad's input to every peripheral at once.)");

  o.print("gating SM pc   : "); o.print(pc0); o.print(" then "); o.print(pc1);
  o.print("   (program base "); o.print(offGating);
  o.print(", COUNT entry +"); o.print(GATING_ENTRY_COUNT);
  o.print(", TIME entry +");  o.print(GATING_ENTRY_TIME); o.println(")");
  o.println("  A pc that never moves means the SM is parked on a wait — i.e. it");
  o.println("  is not seeing edges on its input pin.");
  o.print("gate pin GP4   : "); o.println(gpio_get(PIN_GATE_OUT) ? "high" : "low");
  o.print("out  pin GP5   : "); o.println(gpio_get(PIN_GATED_OUT) ? "high" : "low");
  printPinDuty(o, "chan  ", ampBase);
  printPinDuty(o, "chan  ", ampBase + 1);
  printPinDuty(o, "chan  ", ampBase + 2);
  printPinDuty(o, "cycle ", cyclePin());
  // Say how much of a pattern the 200 ms window actually covered. Every duty
  // above is quantised by that, and once the pattern grows past the window the
  // figures stop meaning anything at all -- a marker that is genuinely high
  // for 49 s out of 113 s reads 0.0% here, which looks exactly like a dead
  // pin. That cost a long detour once; it should not cost a second one.
  {
    const uint64_t per = (uint64_t)carrierPeriodNs
                       * (uint64_t)(onCount + offCount)
                       * (uint64_t)(ringLen ? ringLen : 1);
    const double patterns = per ? 200e6 / (double)per : 0.0;
    o.print("window    : 200 ms = "); o.print(patterns, 2);
    o.print(" patterns (pattern is "); o.print((double)per / 1e6, 1);
    o.println(" ms)");
    if (patterns < 2.0)
      o.println("  ^ TOO SHORT to mean anything -- raise the carrier or shorten"
                " ON/OFF before trusting the percentages above");
  }
  // Pad-level truth for the cycle pin. A duty of 0% has two very different
  // causes -- the pin is not moving, or we cannot SEE it move because the
  // pad's input path is off -- and gpio_get() cannot tell them apart. The
  // sensor node measuring a healthy marker on the wire while this read zero is
  // exactly the case that needs separating.
  {
    const uint cp = cyclePin();
    o.print("cycle pad GP"); o.print(cp);
    o.print(" : func=");  o.print((int)gpio_get_function(cp));
    o.print(" ie=");      o.print((pads_bank0_hw->io[cp] & PADS_BANK0_GPIO0_IE_BITS) ? 1 : 0);
    o.print(" od=");      o.print((pads_bank0_hw->io[cp] & PADS_BANK0_GPIO0_OD_BITS) ? 1 : 0);
    o.print(" iso=");     o.print((pads_bank0_hw->io[cp] & (1u << 8)) ? 1 : 0);
    o.print(" in=");      o.print(gpio_get(cp) ? 1 : 0);
    o.print(" ctrl=0x");  o.print(io_bank0_hw->io[cp].ctrl, HEX);
    // The live DMA words, not the pretty-printed flag: [1] is the gap mask and
    // [2] the first pulse's mask, and CYCLE_MASK (0x10) has to be set in both
    // for GP22 to go high and stay high across a burst.
    {
      const uint32_t *tb = ringLen ? elongRing[0] : elongTable;
      o.print("  table[0..3]=");
      for (int q = 0; q < 4; q++) { o.print("0x"); o.print(tb[q], HEX); o.print(" "); }
      o.print(" CYCLE_MASK=0x"); o.print(CYCLE_MASK, HEX);
      o.print(" ringLen="); o.print(ringLen);
    }
    // What the PIO is ACTUALLY putting on the pads, straight from its debug
    // registers -- the one view that is not an inference. padoe says whether
    // the state machine is driving the pin at all; padout says the level it is
    // driving. A pin with padoe=0 is not being driven no matter how correct
    // the table and the pad configuration look.
    {
      const uint32_t oe = pioElong->dbg_padoe, ou = pioElong->dbg_padout;
      o.print("  PIO padoe/padout: GP"); o.print(ampBase);
      o.print("="); o.print((oe >> ampBase) & 1); o.print("/"); o.print((ou >> ampBase) & 1);
      o.print("  GP"); o.print(ampBase + 1);
      o.print("="); o.print((oe >> (ampBase+1)) & 1); o.print("/"); o.print((ou >> (ampBase+1)) & 1);
      o.print("  GP"); o.print(cp);
      o.print("="); o.print((oe >> cp) & 1); o.print("/"); o.print((ou >> cp) & 1);
    }
    o.print("  (chan pad GP"); o.print(ampBase);
    o.print(" ie=");      o.print((pads_bank0_hw->io[ampBase] & PADS_BANK0_GPIO0_IE_BITS) ? 1 : 0);
    o.print(" iso=");     o.print((pads_bank0_hw->io[ampBase] & (1u << 8)) ? 1 : 0);
    o.println(")");
  }
}
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
void loop() {
  // Nothing here is timing-critical: PIO owns the waveform and keeps running
  // whatever the CPU does. That is the whole payoff of the port — on the Nano
  // this loop *was* the waveform.
  pollInterlock();           // safety first, literally: before any input that
                             // could ask the output to come back on
  pollInputWatch();          // raw edges first, so a step is always
  pollEncoder();             // preceded in the log by the edges that
  pollEncoder2();            // produced it
  pollEncoder3();
  pollButtons();
  pollSerial();
  freqPoll();
  netPoll();
  pollRamp();
  fsweepPoll();
  cfgPoll(Serial);            // writes at most once per editing session

  // Close a one-shot RUN window. Signed compare so it survives millis() wrap.
  if (runUntilMs && (int32_t)(millis() - runUntilMs) >= 0) {
    runUntilMs = 0;
    outputEnabled = false;
    applyGate();
    Serial.print("RUN complete ("); Serial.print(runLenMs); Serial.println(" ms)");
  }

  gpio_put(PIN_STATUS_LED, outputLive() && gpio_get(PIN_GATE_OUT));
}
