cbake6807/PICO-SIGGEN-v1/(commit log)

2026-08-09 Gated pulse generator for Raspberry Pi Pico 2 W
    Burst timing is generated entirely in PIO state machines, so pulse widths
    land on exact integer clocks and nothing the CPU does can perturb the
    output — measured stable while the board serves its web UI to four
    clients at once.
    - bursts of N pulses gated off, or a timed gate window
    - per-pulse elongation, explicit per-pulse SEQ tables, per-burst
    TRAIN amplitude rings, and a T1 sweep across bursts
    - three sequenced channel outputs (offset or sync) plus a cycle marker
    on GP22 that is high for burst 1 of the pattern only, giving a stable
    scope trigger with holdoff off
    - settings persisted in flash with a CRC, at a fixed addr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
    [GatedPulsePico.ino, webui.h]
2026-08-09 Reset to a state that actually shows output on every pin
    "Known state" set phase mode to OFF, which idles GP18-20 and the GP22
    cycle marker and routes everything to GP5 alone. That is the wrong
    behaviour for a button whose entire purpose is to be pressed when nothing
    is coming out: with probes on the channels, resetting silently killed
    four of the five outputs and looked identical to the fault it was meant
    to clear.
    R now lands on offset x3, so the three channels, the cycle marker and GP5
    are all live after a reset. Verified on hardware: 1.7% duty on each of
    GP18/19/20 and 33.5% on GP22, the expected shares for a three-burst ring.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
    [GatedPulsePico.ino, webui.h]
2026-08-24 HV interlock, 100-pulse bursts, and two persistence fixes
    Adds an optional enclosure interlock on GP26 and raises the burst limit
    from 25 to 100, plus two bugs found while testing those.
    HV enclosure interlock (GP26, board pin 31)
    Off by default; LOCK 1 enables, ARM clears a trip. Closed to ground is
    the safe state, chosen so every failure mode lands on "unsafe": a cut
    wire, a dead sensor, or a connector never plugged in all float to the
    internal pull-up and read open.
    Trips latch -- closing the lid does not restart the output -- and ARM
    is refused until the input has been steadily closed for 250 ms, so an
    intermittent contact cannot be armed into. Trip confirmation is 2 ms,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
    [GatedPulsePico.ino, webui.h]
2026-09-17 docs: make toolchain install commands work in Windows Command Prompt
    The additional_urls step used a bash `\` line continuation, which cmd.exe
    treats as literal text. That saved `\` and `\https://...` as board manager
    URLs, so every arduino-cli command then failed with "unsupported protocol
    scheme" and "first path segment in URL cannot contain colon".
    Put it on one line, and use `config set` so re-running it replaces any bad
    entries left by the old instructions.
2026-09-17 docs: step-by-step flashing guide for first-time command-line users
    The flashing instructions assumed you already had the code and knew to run
    the build from inside its folder. Someone following them on Windows installed
    the toolchain but had no GatedPulsePico folder, and ran the commands from
    their home directory.
    Rewrite "Flash it" as numbered steps: download and unzip the repo, install
    arduino-cli, open a terminal, install the core, cd into the code folder (and
    check with dir), plug in with BOOTSEL, then build, find the port and upload.
    Add troubleshooting for running from the wrong folder and for the broken `\`
    URL left by the old two-line command. Give the Windows copy command for
    secr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
2026-09-26 Continuous frequency sweep, selectable channels, better DIAG
    FSWEEP -- continuous frequency sweep
    Walks a 50% square from ~0 up to a ceiling (default 10 kHz) and back,
    repeating, with no gating at all. One tone on GP5, mirrored on GP2, and
    on every selected channel pin together.
    Frequency comes from the PIO CLOCK DIVIDER, not from new counts.
    gate_gen pulls its hi/lo once and loops on registers, so changing the
    counts means re-initing the state machine -- which resets its program
    counter and emits a runt pulse on every step of the sweep. Writing
    CLKDIV on a live SM changes the rate with no restart and no runt, and
    holds the duty at exactly 50% across the band because hi an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
    [GatedPulsePico.ino, webui.h]
2026-11-06 v2 firmware: glitch-free live edits, OTA updates, rebuilt web UI, overlay
    - Edits retune the running engine instead of restarting it: a new
    carrier_live PIO program (packed hi/lo word, nonblocking pull per period)
    for the carrier and TIME gate; COUNT gating re-reads a packed on/off word
    per burst (OFF=0 is one-shot); the elongation/offset engine double-buffers
    its burst tables and switches at a burst boundary. LIVE 0|1 to A/B it.
    - Over-the-air updates: POST /update (basic auth, OTA_PASS in secrets.h),
    `make ota`; 2 MB sketch + 2 MB LittleFS staging, cleared at boot.
    - PULSE <t1> <t2> sets the pair atomically; FW_VERSION 2.0.0 + git build
    stamp in P, /state and the page footer; p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
2026-11-06 Android app 1.4 and the SensorNode firmware
    The app finds the board by mDNS, hosts its web UI, keeps retrying the board
    you picked (and follows it to a new IP by name), shows connection status
    with a heartbeat, a banner and haptics, and reloads after a firmware update.
    Built with the bare SDK tools; the signed APK is committed at
    android/GatedPulse.apk and the web UI links to it here.
    SensorNode is the firmware for the optional second board the i/o tab reads.
